RetroRemake/OtterX/README.md

# OtterX

An Open Source 6502-based, Commander X16-compatible, 8-bit Computer

## Where to buy?

Looking to order and build your own OtterX? Official kits are available from:

[Wavicle's store on Lectronz](https://lectronz.com/products/otterx-8-bit-retro-computer)
