RetroRemake/OtterX/Vega_EV1/OtterX_Vega_Packing_List.xlsx

OtterX Parts List
Bag 1:
 | D1, D3, D6, D7, D8, D9, D10, D11, D13, D14, D15, D19 | 12 | 1N4148 | Small Signal Diode
 | D2 | 1 | 1N5819 | Schottky diode
 | D4 | 1 | LED_GRN | Power ON
 | D5 | 1 | LED_YEL | Power SBY
 | D16, D20, D21, D22, D23, D24, D25, D26, D27, D28 | 10 | P4KE6.8CA | TVS Diode
 | D18 | 1 | LED_RED | Activity
 | R1, R2, R4, R5, R6, R13, R30, R31, R32, R33, R34 | 11 | 1K | Resistor
 | R3,R10,R12 | 3 | 2K2 | Resistor
 | R7,R8,R28 | 3 | 560R | Resistor
 | R9,R11,R16,R17,R19,R20 | 6 | 10K | Resistor
 | R15,R18,R21,R22 | 4 | 15K | Resistor
 | R23,R24,R27 | 3 | 100R | Resistor
 | R29 | 1 | 390R | Resistor
 | RN1 | 1 | 2K2 | 7 pin network resistor
 | RN2,RN3 | 2 | 2K2 | 5 pin network resistor
 | RN4 | 1 | 3K3 | 5 pin network resistor
 | RN5 | 1 | 2K2 | 8 pin network resistor
 | L1 | 1 | 470uH | Inductor
 | FB1 | 1 | FerriteBead_Small | Ferrite Bead
Bag 2:
 | C1, C2, C3, C4, C5, C6, C7, C8, C9, C10, C11, C12, C21, C22, C23, C24, C25, C26, C27, C28, C41, C44, C50, C54, C58, C59 | 26 | 0.1u | Capacitor
 | C13,C14,C15,C18,C19,C20 | 6 | 330p | Capacitor
 | C16,C17 | 2 | 3p | Capacitor
 | C42,C43 | 2 | 1n | Film Capacitor
 | C46,C47 | 2 | 2.2u | Film Capacitor
 | C51,C52,C53,C57 | 4 | 10u | Electrolytic Capacitor
 | C55,C56 | 2 | 3.3n | Film Capacitor
 | Q1,Q2,Q3 | 3 | 2N7000 | N-channel FET
 | Y1 | 1 | ECS-.327-6-13X | Real-time clock crystal
Bag 3:
 | H1,H2,H3,H4 | 4 | M3 18mm Brass Standoffs | M3 18mm Brass Standoffs
 | H1,H2,H3,H4 | 8 | M3x5mm screws | M3 screws
 | H1,H2,H3,H4 | 4 | M3 1mm nylon washers | M3 1mm Nylon Washers
 | BT1 | 1 | BAT-HLD-001-THM | CR2032 Battery Clip
 | F1 | 1 | JK30 | 3A Resettable Fuse
 | F3 | 1 | RXEF110 | 1.1A Resettable Fuse
 | F4 | 1 | RXEF025 | 250mA Resettable Fuse
 | F5 | 1 | RXEF010 | 100mA Resettable Fuse
Bag 4:
 | J1 | 1 | VERA_CONN | 2x13 2.54mm male header
 | J2 | 1 | VIA2 Header | 2x12 2.54mm male header
 | J3,J17,J21 | 3 | IDC_2x03 | 2x3 2.54mm shrouded box header
 | J5 | 1 | YM CT Out | 1x3 2.54mm male pin header
 | J6 | 1 | Ext. NMI | 1x2 2.54mm male header
 | J7 | 1 | RTC GPIO | 1x2 2.54mm male header
 | J9 | 1 | I2C | JST PH 4-pin connector
 | J10 | 1 | 1.5MB RAM Expansion | 2x20 2mm female header
 | J11 | 1 | KMDGX-6SG | Stacked PS/2 connector
 | J12 | 1 | VIA1 Extra Pins | 2x4 2.54mm male header
 | J14 | 1 | Flash WR EN | 1x2 2.54mm male header
 | J14+ | 1 | 2.54mm Jumper Cap | 2.54mm Jumper Cap
 | J16 | 1 | ATX-24 | ATX Power Socket
 | J25 | 1 | PS2 Pwr Src | 1x3 2.54mm Male pin header
 | J26 | 1 | Front Panel | 2x5 2.54mm Male pin header
 | J27 | 1 | EXTRAM_ENABLE | 1x3 2mm male pin header
 | J27+ | 1 | 2mm Jumper Cap | 2mm Jumper Cap
 | J29 | 1 | SD1-3525 | 3.5mm line level audio jack
 | P1 | 1 | Expansion slot | 2x30 card edge connector
 | SW1,SW2,SW3 | 3 | FSM4JH | Tactile switch / button
IC Box
 | U1 | 1 | W65C02S/W65C816S | CPU
 | U1-Opt | 1 |  | 40 pin DIP socket
 | U2 | 1 | W65C22S | VIA1
 | U2-Opt | 1 |  | 40 pin DIP socket
 | U3 | 1 | 74LS06 | Open Collector Inverter
 | U4 | 1 | 74AC10 | Triple 3-input NAND
 | U5,U6 | 2 | 74AHCT273 | Octal D Flip Flop
 | U7 | 1 | SST39SF040 | ROM
 | U7-Opt | 1 |  | 32 pin DIP socket, or ZIF socket
 | U8 | 1 | AS6C1008-55PCN | Low RAM
 | U9 | 1 | AS6C4008-55PCN | High RAM
 | U11 | 1 | 74ACT163 | Clock stretch counter
 | U12 | 1 | ATtiny861-20P | System Microcontroller
 | U13 | 1 | MCP7940N-xP | Real-time clock
 | U14 | 1 | 74ACT00 | Quad NAND gate
 | U15,U17 | 2 | 74AHCT02 | Quad NOR gate
 | U16 | 1 | 74AHCT04 | Hex Inverter
 | U18 | 1 | 74AHCT32 | Quad OR gate
 | U19,U20 | 2 | 74AC20 | Dual 4-input NAND
 | U21 | 1 | 74AHCT138 | 3-to-8 Decoder
 | U22 | 1 | TL074 | Audio mixer quad Op Amp
 | U24-Opt | 1 |  | 24 pin wide DIP socket
 | U25-Opt | 1 |  | 16 pin DIP socket
 | U26 | 1 | LM324 | Quad Op Amp
 | X1 | 1 | ACH-16.000MHZ-EK | System clock oscillator
 | X1-Opt |  |  | 4 pin oscillator socket
 | X2 | 1 | ECS-2100AX-3.579545MHZ | FM Audio oscillator
 | K1 | 1 | HK19F | Audio mute relay
VERA
 | VERA | 1 | VERA | VERA
OPM:
 | U24 | 1 | OPM2151 | FM Audio
 | U25 | 1 | OPM DAC | DAC for FM Audio
Loose
 | J18 | 1 | SNES0 | SNES Connector Left
 | J19 | 1 | SNES1 | SNES Connector Right
