RetroRemake/OtterX/(threads)

Thread 1 (2025-04-19):

[Sirius] U22 must be TL074

jburks, 2025-04-19:
Silkscreen for U22 says "LM324/TL074". This part must be TL074 because LM324 doesn't have sufficient power rail noise immunity.

Thread 2 (2025-04-19):

[Sirius] D23, D25, D26 are backwars

jburks, 2025-04-19:
The footprint for D23, D25, and D26 are backwards and will prevent keyboard and mouse from working even polarized TVS diodes are used.

Thread 4 (2025-04-19):

[Sirius] NES Pull-ups are too strong

jburks, 2025-04-19:
The NES used 10K pull-ups. Current pull-ups are 2.2K through RN6. Super cheap replacement NES controllers sample the select button and transmit data on the same pin causing them to rely on the pull-up being weak.

Thread 5 (2025-04-19):

[Sirius] ROM Chip Select is not muted when ROM bank is >= 32

jburks, 2025-04-19:
ROM is responding when a cartridge is being addressed. This requires a bodge and bodge board to correct.

jburks, 2025-04-19:
It is possible to connect /ROMEN, ROMBA19, ROMBA20, and ROMBA21 to the two unused gates on U18 and then use two diodes to wire-OR their outputs into a new /LOWROMEN signal. The routing congestion around U18 is pretty high; this would probably require re-routing a dozen other signals.

Thread 6 (2025-04-19):

[Sirius] VIA2 connector missing reset

jburks, 2025-04-19:
Pin 21 of VIA2 header should be /RES but is unconnected.

Thread 7 (2025-04-19):

[Sirius] Memory expansion doesn't clear cartridge keepout

jburks, 2025-04-19:
The memory expansion header, J10 is too close to the card edge connector for a cartridge in a Famicom shell to be inserted when the memory expansion is present.

Best solution here may be a 90-degree riser card due to the manufacturing complexity of a port extender.

Thread 8 (2025-04-19):

[Sirius] OPM2151 doesn't clear cartridge keepout

jburks, 2025-04-19:
The YM2151 footprint is close to P1 and causes cartridge shells to rub up against OPM2151 when it is installed instead of YM2151.

Thread 10 (2025-04-20):

[Sirius] Digital signals routed across analog mixer

jburks, 2025-04-20:
/VERA_CS and /VIA_CS are routed across the analog mixer. Probably not a big deal, but this could result in coupling from these digital signals onto the analog signal. The coupling would most likely occur every VBLANK interrupt which is just below 60Hz.

Thread 11 (2025-04-20):

[Sirius] NESDAT0 should go through filtering cap

jburks, 2025-04-20:
The filtering cap C15 connected to NESDAT0 should sit between pin 4 of the SNES port and the VIA pin. Currently it is only connected through the TVS diode.

Thread 13 (2025-04-20):

[Sirius] RTC load caps may be wrong value

jburks, 2025-04-20:
The load caps C16 and C17 are currently 3pF each into a 6pf crystal. The total capacitance seen by the crystal may be less than 6pf.

Thread 14 (2025-04-20):

[Sirius] DIP footprints may need 1mm holes

jburks, 2025-04-20:
The DIP footprints with short wide pads have 0.8mm holes. This makes desoldering significantly more challenging. These maybe need to be 1.0mm.

Thread 15 (2025-04-20):

[Sirius] DIN-6 Footprint doesn't match part

jburks, 2025-04-20:
The DIN-6 Footprint used doesn't match that of the AliEx part sourced. Pins 7 and 8 have different spacing.

Thread 16 (2025-06-14):

Q1, Q2, and Q3 need wider footprints

jburks, 2025-06-14:
The 1.27mm spacing on TO-92 transistors is creating a lot of assembly errors. Replace with kinked-pin / wide TO-92 footprint to ease assembly.
