RetroRemake/OtterX/VIA2Expansion/VIA2Expansion.kicad_pcb

## KiCad design VIA2Expansion/VIA2Expansion.kicad_pcb (2026-06-11)

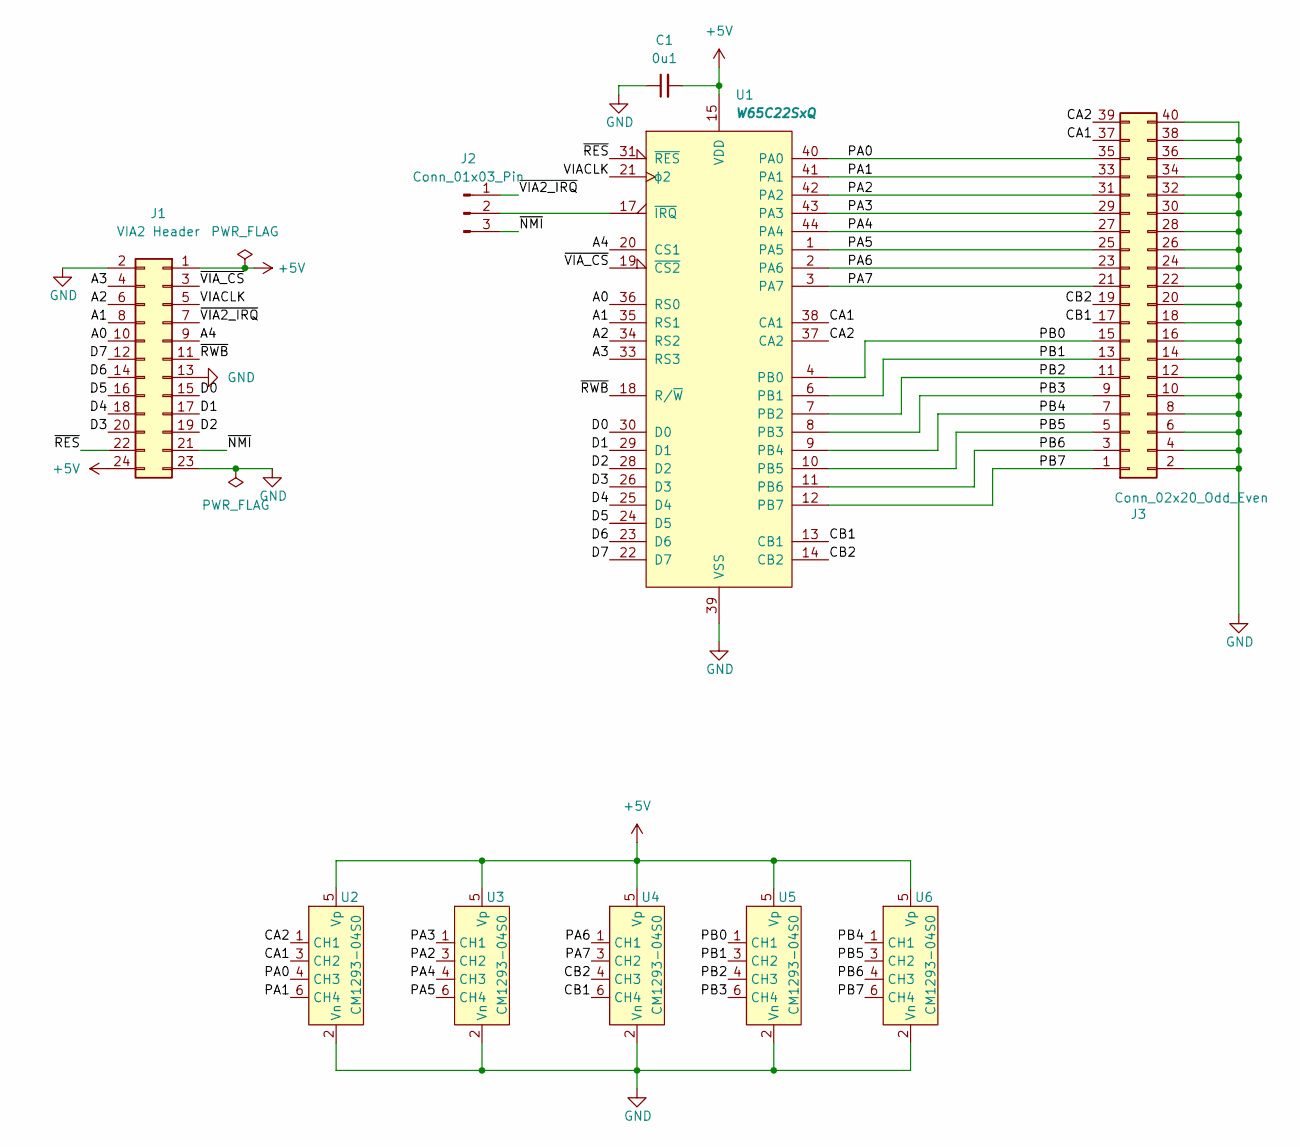
[picture p1: schematic VIA2Expansion.kicad_sch]

Parts:
C1: 0u1; C_0603_1608Metric
J1: VIA2 Header; PinSocket_2x12_P2.54mm_Horizontal
J2: Conn_01x03_Pin; PinHeader_1x03_P2.54mm_Vertical
J3: Conn_02x20_Odd_Even; IDC-Header_2x20_P2.54mm_Vertical
U1: W65C22SxQ; TQFP-44_10x10mm_P0.8mm
U2, U3, U4, U5, U6: CM1293-04S0; SC-74-6_1.55x2.9mm_P0.95mm

Connections:
+5V: C1.2, J1.1, J1.24, U1.15 (VDD), U2.5 (Vp), U3.5 (Vp), U4.5 (Vp), U5.5 (Vp), U6.5 (Vp)
/A0: J1.10, U1.36 (RS0)
/A1: J1.8, U1.35 (RS1)
/A2: J1.6, U1.34 (RS2)
/A3: J1.4, U1.33 (RS3)
/A4: J1.9, U1.20 (CS1)
/CA1: J3.37, U1.38 (CA1), U2.3 (CH2)
/CA2: J3.39, U1.37 (CA2), U2.1 (CH1)
/CB1: J3.17, U1.13 (CB1), U4.6 (CH4)
/CB2: J3.19, U1.14 (CB2), U4.4 (CH3)
/D0: J1.15, U1.30 (D0)
/D1: J1.17, U1.29 (D1)
/D2: J1.19, U1.28 (D2)
/D3: J1.20, U1.26 (D3)
/D4: J1.18, U1.25 (D4)
/D5: J1.16, U1.24 (D5)
/D6: J1.14, U1.23 (D6)
/D7: J1.12, U1.22 (D7)
/PA0: J3.35, U1.40 (PA0), U2.4 (CH3)
/PA1: J3.33, U1.41 (PA1), U2.6 (CH4)
/PA2: J3.31, U1.42 (PA2), U3.3 (CH2)
/PA3: J3.29, U1.43 (PA3), U3.1 (CH1)
/PA4: J3.27, U1.44 (PA4), U3.4 (CH3)
/PA5: J3.25, U1.1 (PA5), U3.6 (CH4)
/PA6: J3.23, U1.2 (PA6), U4.1 (CH1)
/PA7: J3.21, U1.3 (PA7), U4.3 (CH2)
/PB0: J3.15, U1.4 (PB0), U5.1 (CH1)
/PB1: J3.13, U1.6 (PB1), U5.3 (CH2)
/PB2: J3.11, U1.7 (PB2), U5.4 (CH3)
/PB3: J3.9, U1.8 (PB3), U5.6 (CH4)
/PB4: J3.7, U1.9 (PB4), U6.1 (CH1)
/PB5: J3.5, U1.10 (PB5), U6.3 (CH2)
/PB6: J3.3, U1.11 (PB6), U6.4 (CH3)
/PB7: J3.1, U1.12 (PB7), U6.6 (CH4)
/VIACLK: J1.5, U1.21 (ϕ2)
/~NMI: J1.21, J2.3
/~RES: J1.22, U1.31 (~RES)
/~RWB: J1.11, U1.18 (R/~W)
/~VIA2_IRQ: J1.7, J2.1
/~VIA_CS: J1.3, U1.19 (~CS2)
GND: C1.1, J1.2, J1.13, J1.23, J3.2, J3.4, J3.6, J3.8, J3.10, J3.12, J3.14, J3.16, J3.18, J3.20, J3.22, J3.24, J3.26, J3.28, J3.30, J3.32, J3.34, J3.36, J3.38, J3.40, U1.39 (VSS), U2.2 (Vn), U3.2 (Vn), U4.2 (Vn), U5.2 (Vn), U6.2 (Vn)
unnamed: J2.2, U1.17 (~IRQ)

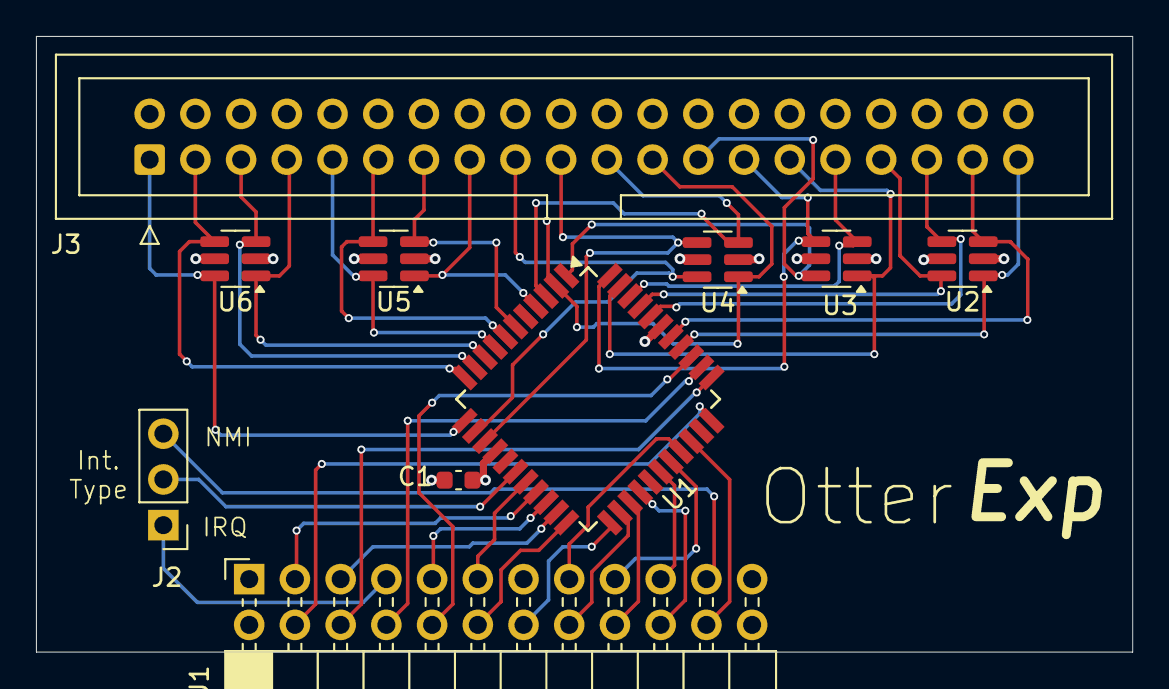
[picture p2: board VIA2Expansion.kicad_pcb from above]

Board: 4 copper layers, 60.9 x 34.2 mm, 10 parts (0 on the bottom side), 42 nets.
