RetroRemake/OtterX/Sirius_DV1/OtterX.kicad_pcb

## KiCad design Sirius_DV1/OtterX.kicad_pcb (2026-06-11)

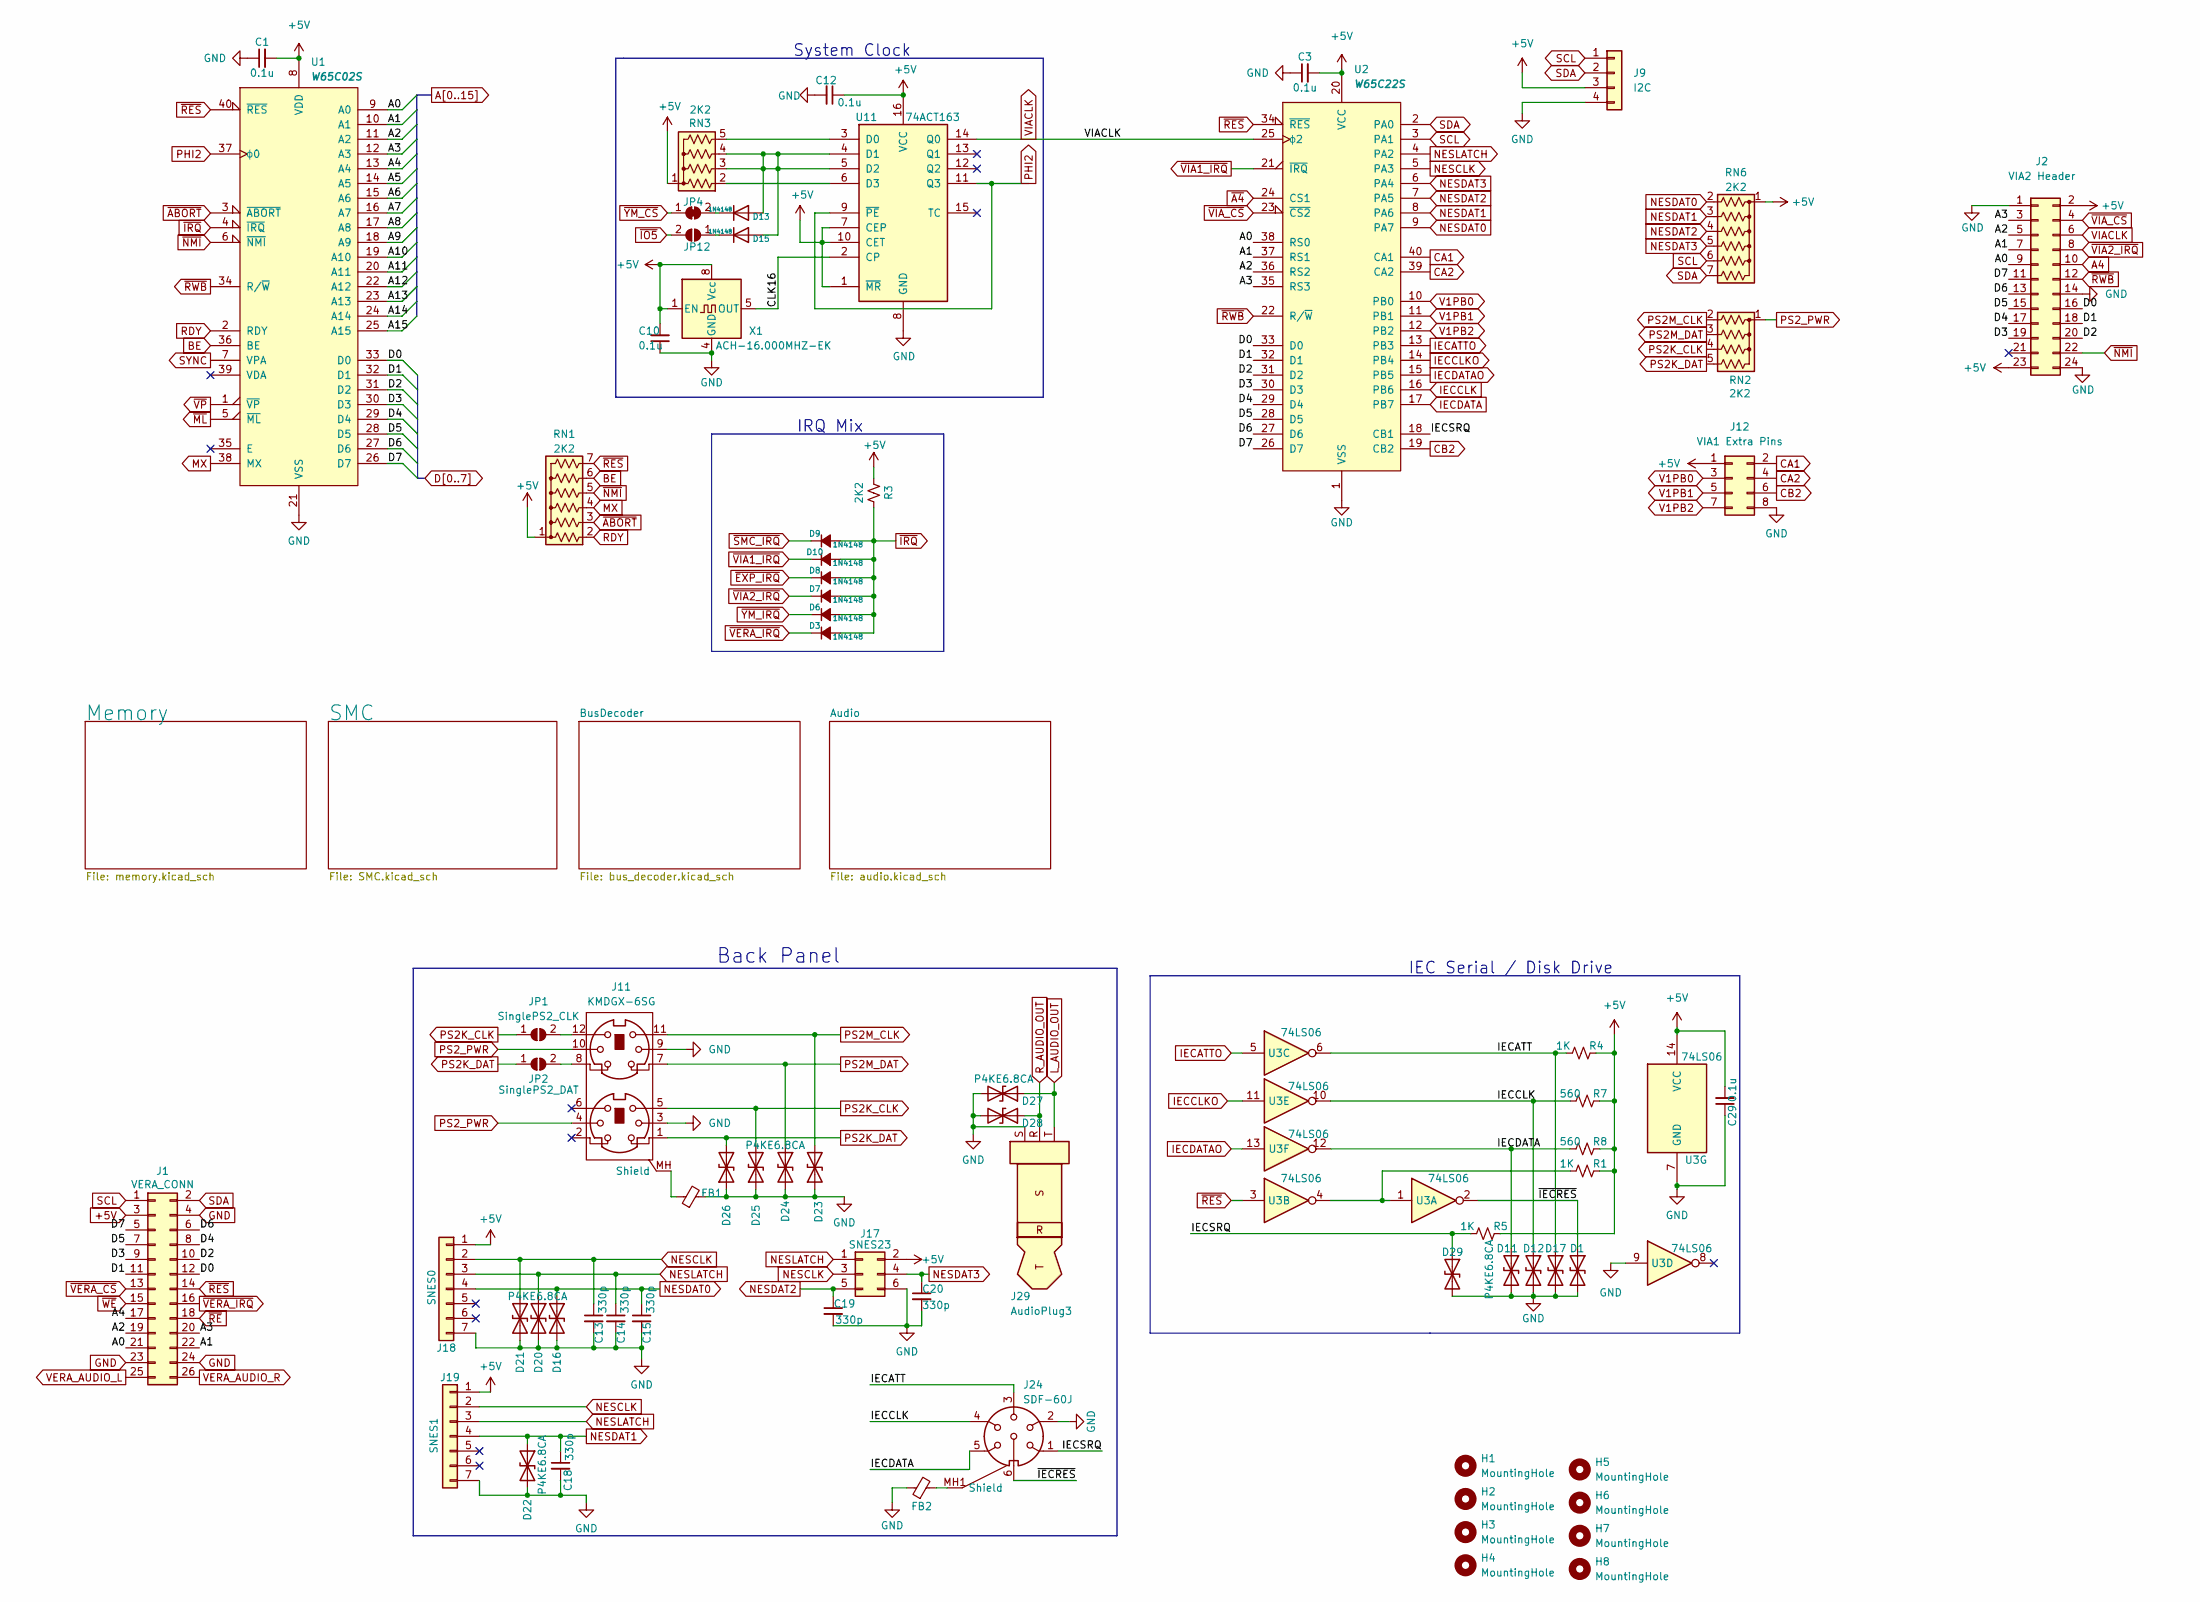
[picture p3: schematic OtterX.kicad_sch]

Parts:
C1, C3, C10, C12, C29: 0.1u; C_Disc_D4.3mm_W1.9mm_P5.00mm
C13, C14, C15, C18, C19, C20: 330p; C_Disc_D4.3mm_W1.9mm_P5.00mm
D1, D11, D12, D16, D17, D20, D21, D22, D23, D24, D25, D26, D27, D28, D29: P4KE6.8CA; D_DO-41_SOD81_P7.62mm_Horizontal
D3, D6, D7, D8, D9, D10: 1N4148; D_DO-34_SOD68_P7.62mm_Horizontal
D13, D15: 1N4148; D_DO-35_SOD27_P7.62mm_Horizontal
FB1, FB2: FerriteBead_Small; L_Axial_L5.0mm_D3.6mm_P10.00mm_Horizontal_Murata_BL01RN1A2A2
H1, H2, H3, H4: MountingHole; MountingHole_3.2mm_M3
H5, H6, H7, H8: MountingHole; MountingHole_4.3mm_M4
J1: VERA_CONN; PinHeader_2x13_P2.54mm_Vertical
J2: VIA2 Header; PinSocket_2x12_P2.54mm_Vertical
J9: I2C; JST_PH_B4B-PH-K_1x04_P2.00mm_Vertical
J11: KMDGX-6SG; Kycon KMDGX-6SG P-S4N
J12: VIA1 Extra Pins; PinHeader_2x04_P2.54mm_Vertical
J17: SNES23; PinSocket_2x03_P2.54mm_Vertical
J18: SNES0; SNES_L
J19: SNES1; SNES_R
J24: SDF-60J; SDF60J
J29: AudioPlug3; Jack_3.5mm_CUI_SJ1-3525N_Horizontal
JP1: SinglePS2_CLK; SolderJumper-2_P1.3mm_Bridged_Pad1.0x1.5mm
JP2: SinglePS2_DAT; SolderJumper-2_P1.3mm_Bridged_Pad1.0x1.5mm
JP4: SolderJumper_2_Bridged; SolderJumper-2_P1.3mm_Bridged_Pad1.0x1.5mm
JP12: IO3 Clk Stretch; SolderJumper-2_P1.3mm_Open_Pad1.0x1.5mm
R1, R4, R5: 1K; R_Axial_DIN0207_L6.3mm_D2.5mm_P7.62mm_Horizontal
R3: 2K2; R_Axial_DIN0207_L6.3mm_D2.5mm_P10.16mm_Horizontal
R7, R8: 560; R_Axial_DIN0207_L6.3mm_D2.5mm_P7.62mm_Horizontal
RN1, RN6: 2K2; R_Array_SIP7
RN2, RN3: 2K2; R_Array_SIP5
U1: W65C02S; DIP-40_W15.24mm-ShortWidePads
U2: W65C22S; DIP-40_W15.24mm-ShortWidePads
U3: 74LS06; DIP-14_W7.62mm_ShortWidePads
U11: 74ACT163; DIP-16_W7.62mm_ShortWidePads
X1: ACH-16.000MHZ-EK; Oscillator_DIP-8

Connections:
+5V: C1.2, C3.2, C10.2, C12.1, C29.2, J1.3, J2.2, J2.23, J9.3, J12.1, J17.2, J18.1, J19.1, R1.1, R3.1, R4.1, R5.1, R7.1, R8.1, RN1.1 (common), RN3.1 (common), RN6.1 (common), U1.8 (VDD), U2.20 (VCC), U3.14 (VCC), U11.1 (~MR), U11.7 (CEP), U11.10 (CET), U11.16 (VCC), X1.1 (EN), X1.8 (Vcc); also elsewhere on the board
/CLK16: U11.2 (CP), X1.5 (OUT)
/IECATT: D17.1 (A1), J24.3, R4.2, U3.6
/IECSRQ: D29.1 (A1), J24.1, R5.2, U2.18 (CB1)
/~IECRES: D1.1 (A1), J24.6, U3.2
A0: J1.21, J2.9, U1.9 (A0), U2.38 (RS0); also elsewhere on the board
A1: J1.22, J2.7, U1.10 (A1), U2.37 (RS1); also elsewhere on the board
A2: J1.19, J2.5, U1.11 (A2), U2.36 (RS2); also elsewhere on the board
A3: J1.20, J2.3, U1.12 (A3), U2.35 (RS3); also elsewhere on the board
A4: J1.17, J2.10, U1.13 (A4); also elsewhere on the board
A5: U1.14 (A5); also elsewhere on the board
A6: U1.15 (A6); also elsewhere on the board
A7: U1.16 (A7); also elsewhere on the board
A8: U1.17 (A8); also elsewhere on the board
A9: U1.18 (A9); also elsewhere on the board
A10: U1.19 (A10); also elsewhere on the board
A11: U1.20 (A11); also elsewhere on the board
A12: U1.22 (A12); also elsewhere on the board
A13: U1.23 (A13); also elsewhere on the board
A14: U1.24 (A14); also elsewhere on the board
A15: U1.25 (A15); also elsewhere on the board
BE: RN1.6 (R5), U1.36 (BE); also elsewhere on the board
CA1: J12.2, U2.40 (CA1)
CA2: J12.4, U2.39 (CA2)
CB2: J12.6, U2.19 (CB2)
D0: J1.12, J2.16, U1.33 (D0), U2.33 (D0); also elsewhere on the board
D1: J1.11, J2.18, U1.32 (D1), U2.32 (D1); also elsewhere on the board
D2: J1.10, J2.20, U1.31 (D2), U2.31 (D2); also elsewhere on the board
D3: J1.9, J2.19, U1.30 (D3), U2.30 (D3); also elsewhere on the board
D4: J1.8, J2.17, U1.29 (D4), U2.29 (D4); also elsewhere on the board
D5: J1.7, J2.15, U1.28 (D5), U2.28 (D5); also elsewhere on the board
D6: J1.6, J2.13, U1.27 (D6), U2.27 (D6); also elsewhere on the board
D7: J1.5, J2.11, U1.26 (D7), U2.26 (D7); also elsewhere on the board
GND: C1.1, C3.1, C10.1, C12.2, C13.2, C14.2, C15.2, C18.2, C19.2, C20.2, C29.1, D1.2 (A2), D11.2 (A2), D12.2 (A2), D16.2 (A2), D17.2 (A2), D20.2 (A2), D21.2 (A2), D22.2 (A2), D23.1 (A1), D24.2 (A2), D25.1 (A1), D26.1 (A1), D27.2 (A2), D28.2 (A2), D29.2 (A2), FB1.2, FB2.1, J1.4, J1.23, J1.24, J2.1, J2.14, J2.24, J9.4, J11.3, J11.9, J12.8, J17.6, J18.7, J19.7, J24.2, J29.S, U1.21 (VSS), U2.1 (VSS), U3.7 (GND), U3.9, U11.8 (GND), X1.4 (GND); also elsewhere on the board
IECATTO: U2.13 (PB3), U3.5
IECCLK: D12.1 (A1), J24.4, R7.2, U2.16 (PB6), U3.10
IECCLKO: U2.14 (PB4), U3.11
IECDATA: D11.1 (A1), J24.5, R8.2, U2.17 (PB7), U3.12
IECDATAO: U2.15 (PB5), U3.13
L_AUDIO_OUT: D27.1 (A1), J29.T; also elsewhere on the board
MX: RN1.4 (R3), U1.38 (MX)
NESCLK: C13.1, D21.1 (A1), J17.3, J18.2, J19.2, U2.5 (PA3)
NESDAT0: C15.1, D16.1 (A1), J18.4, RN6.2 (R1), U2.9 (PA7)
NESDAT1: C18.1, D22.1 (A1), J19.4, RN6.3 (R2), U2.8 (PA6)
NESDAT2: C19.1, J17.5, RN6.4 (R3), U2.7 (PA5)
NESDAT3: C20.1, J17.4, RN6.5 (R4), U2.6 (PA4)
NESLATCH: C14.1, D20.1 (A1), J17.1, J18.3, J19.3, U2.4 (PA2)
unnamed: D13.2 (A), D15.2 (A), RN3.3 (R2), RN3.4 (R3), U11.4 (D1), U11.5 (D2)
unnamed: D13.1 (K), JP4.2 (B)
unnamed: D15.1 (K), JP12.1 (A)
unnamed: FB1.1, J11.MH (Shield)
unnamed: FB2.2, J24.MH1 (Shield), J24.MH2
unnamed: J11.12, JP1.2 (B)
unnamed: J11.8, JP2.2 (B)
unnamed: R1.2, U3.1, U3.4
unnamed: RN3.2 (R1), U11.6 (D3)
unnamed: RN3.5 (R4), U11.3 (D0)
PHI2: U1.37 (ϕ0), U11.9 (~PE), U11.11 (Q3); also elsewhere on the board
PS2K_CLK: D25.2 (A2), J11.5, JP1.1 (A), RN2.4 (R3); also elsewhere on the board
PS2K_DAT: D26.2 (A2), J11.1, JP2.1 (A), RN2.5 (R4); also elsewhere on the board
PS2M_CLK: D23.2 (A2), J11.11, RN2.2 (R1); also elsewhere on the board
PS2M_DAT: D24.1 (A1), J11.7, RN2.3 (R2); also elsewhere on the board
PS2_PWR: J11.4, J11.10, RN2.1 (common); also elsewhere on the board
RDY: RN1.2 (R1), U1.2 (RDY); also elsewhere on the board
R_AUDIO_OUT: D28.1 (A1), J29.R; also elsewhere on the board
SCL: J1.1, J9.1, RN6.6 (R5), U2.3 (PA1); also elsewhere on the board
SDA: J1.2, J9.2, RN6.7 (R6), U2.2 (PA0); also elsewhere on the board
SYNC: U1.7 (VPA); also elsewhere on the board
V1PB0: J12.3, U2.10 (PB0)
V1PB1: J12.5, U2.11 (PB1)
V1PB2: J12.7, U2.12 (PB2)
VERA_AUDIO_L: J1.25; also elsewhere on the board
VERA_AUDIO_R: J1.26; also elsewhere on the board
VIACLK: J2.6, U2.25 (ϕ2), U11.14 (Q0)
~A4: U2.24 (CS1); also elsewhere on the board
~ABORT: RN1.3 (R2), U1.3 (~ABORT)
~EXP_IRQ: D8.1 (K); also elsewhere on the board
~IO5: JP12.2 (B); also elsewhere on the board
~IRQ: D3.2 (A), D6.2 (A), D7.2 (A), D8.2 (A), D9.2 (A), D10.2 (A), R3.2, U1.4 (~IRQ)
~ML: U1.5 (~ML); also elsewhere on the board
~NMI: J2.22, RN1.5 (R4), U1.6 (~NMI); also elsewhere on the board
~RES: J1.14, RN1.7 (R6), U1.40 (~RES), U2.34 (~RES), U3.3; also elsewhere on the board
~RE: J1.18; also elsewhere on the board
~RWB: J2.12, U1.34 (R/~W), U2.22 (R/~W); also elsewhere on the board
~SMC_IRQ: D9.1 (K); also elsewhere on the board
~VERA_CS: J1.13; also elsewhere on the board
~VERA_IRQ: D3.1 (K), J1.16
~VIA1_IRQ: D10.1 (K), U2.21 (~IRQ)
~VIA2_IRQ: D7.1 (K), J2.8
~VIA_CS: J2.4, U2.23 (~CS2); also elsewhere on the board
~VP: U1.1 (~VP); also elsewhere on the board
~WE: J1.15; also elsewhere on the board
~YM_CS: JP4.1 (A); also elsewhere on the board
~YM_IRQ: D6.1 (K); also elsewhere on the board

Notes on the sheet:
System Clock
Back Panel
IRQ Mix
IEC Serial / Disk Drive

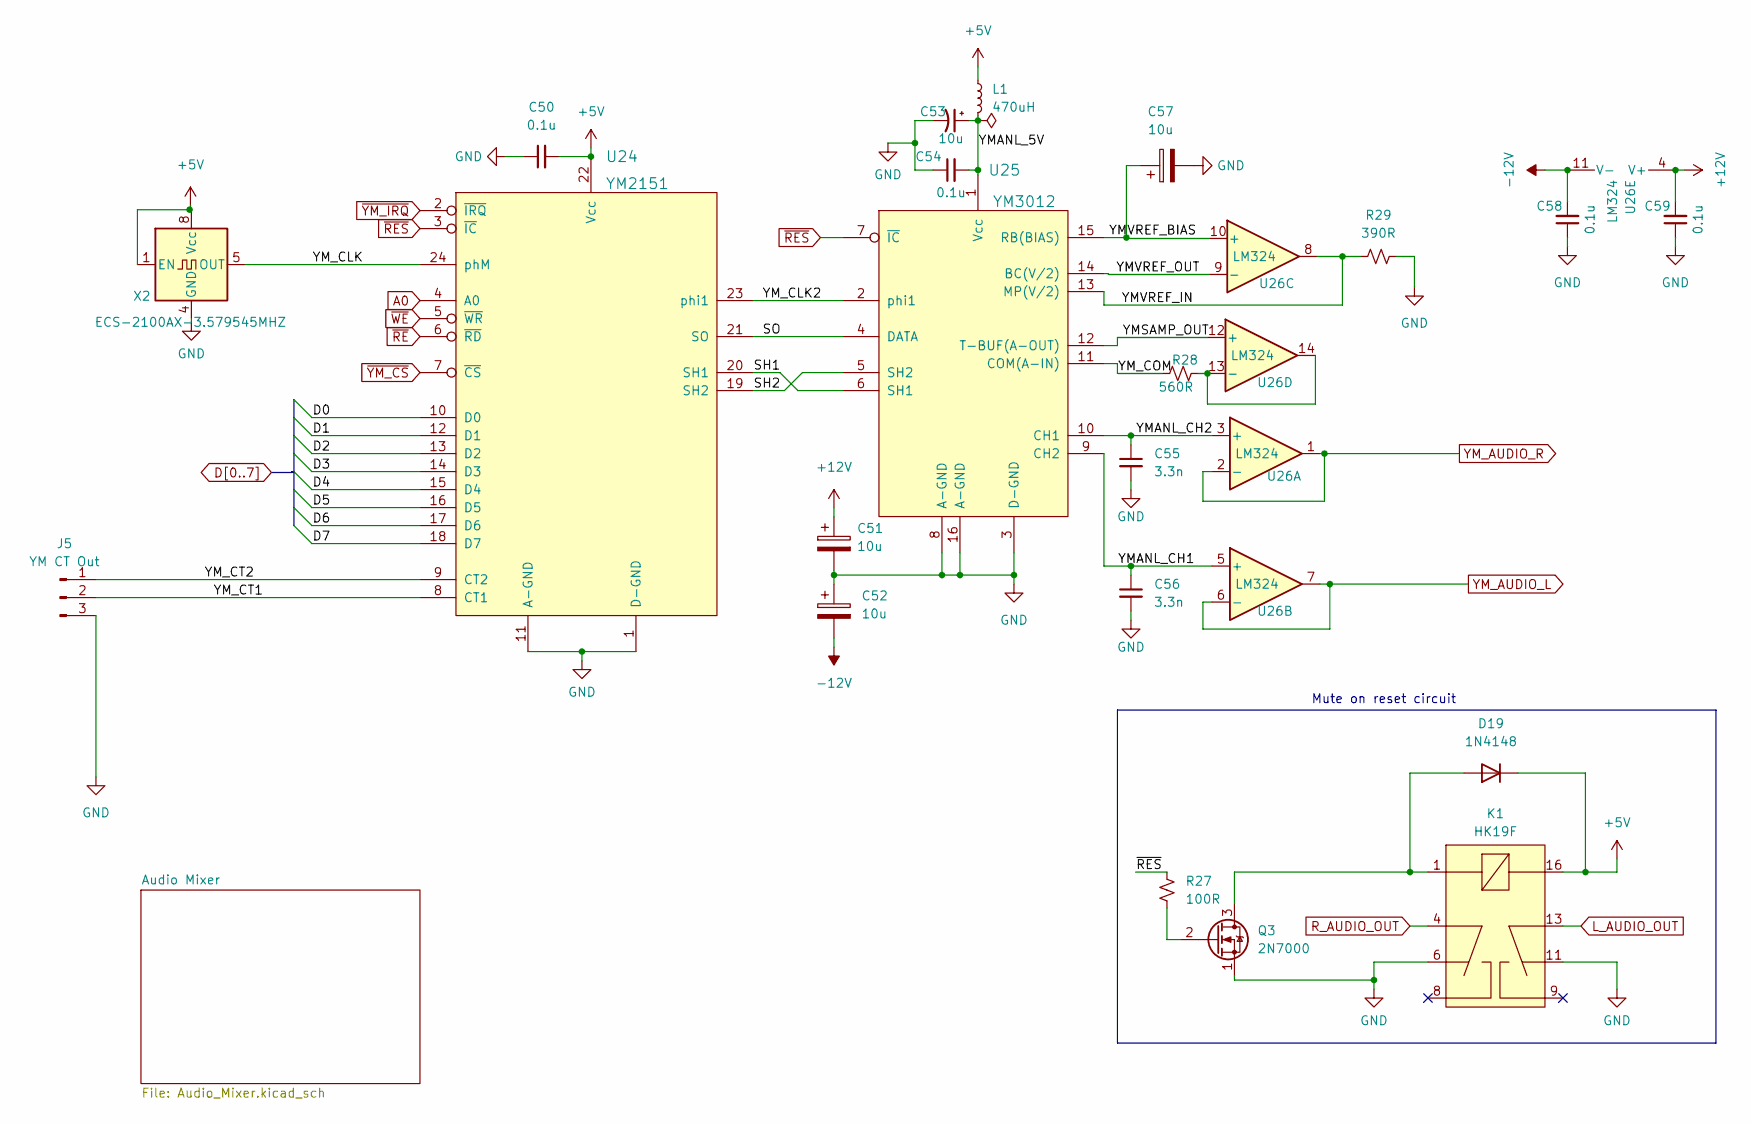
[picture p4: schematic audio.kicad_sch, OtterX]

Parts:
C50, C54, C58, C59: 0.1u; C_Disc_D4.3mm_W1.9mm_P5.00mm
C51, C52, C53, C57: 10u; CP_Radial_D5.0mm_P2.50mm
C55, C56: 3.3n; C_Rect_L7.2mm_W2.5mm_P5.00mm_FKS2_FKP2_MKS2_MKP2
D19: 1N4148; D_DO-35_SOD27_P7.62mm_Horizontal
J5: YM CT Out; PinHeader_1x03_P2.54mm_Vertical
K1: HK19F; HK19F-DPDT-Relay
L1: 470uH; L_Axial_L5.0mm_D3.6mm_P10.00mm_Horizontal_Murata_BL01RN1A2A2
Q3: 2N7000; TO-92_Inline
R27: 100R; R_Axial_DIN0207_L6.3mm_D2.5mm_P7.62mm_Horizontal
R28: 560R; R_Axial_DIN0207_L6.3mm_D2.5mm_P7.62mm_Horizontal
R29: 390R; R_Axial_DIN0207_L6.3mm_D2.5mm_P7.62mm_Horizontal
U24: YM2151; DIP-24_W15.24mm_ShortWidePads
U25: YM3012; DIP-16_W7.62mm_ShortWidePads
U26: LM324; DIP-14_W7.62mm_ShortWidePads
X2: ECS-2100AX-3.579545MHZ; Oscillator_DIP-8

Connections:
+5V: C50.2, D19.1 (K), K1.16, L1.1, U24.22 (Vcc), X2.1 (EN), X2.8 (Vcc); also elsewhere on the board
+12V: C51.1, C59.2, U26.4 (V+); also elsewhere on the board
-12V: C52.2, C58.2, U26.11 (V-); also elsewhere on the board
/Audio/SH1: U24.20 (SH1), U25.6 (SH1)
/Audio/SH2: U24.19 (SH2), U25.5 (SH2)
/Audio/SO: U24.21 (SO), U25.4 (DATA)
/Audio/YMANL_5V: C53.1, C54.2, L1.2, U25.1 (Vcc)
/Audio/YMANL_CH1: C56.1, U25.9 (CH2), U26.5 (+)
/Audio/YMANL_CH2: C55.1, U25.10 (CH1), U26.3 (+)
/Audio/YMSAMP_OUT: U25.12 (T-BUF(A-OUT)), U26.12 (+)
/Audio/YMVREF_BIAS: C57.1, U25.15 (RB(BIAS)), U26.10 (+)
/Audio/YMVREF_IN: R29.1, U25.13 (MP(V/2)), U26.8
/Audio/YMVREF_OUT: U25.14 (BC(V/2)), U26.9 (-)
/Audio/YM_CLK: U24.24 (phM), X2.5 (OUT)
/Audio/YM_CLK2: U24.23 (phi1), U25.2 (phi1)
/Audio/YM_COM: R28.2, U25.11 (COM(A-IN))
/Audio/YM_CT1: J5.2, U24.8 (CT1)
/Audio/YM_CT2: J5.1, U24.9 (CT2)
A0: U24.4 (A0); also elsewhere on the board
D0: U24.10 (D0); also elsewhere on the board
D1: U24.12 (D1); also elsewhere on the board
D2: U24.13 (D2); also elsewhere on the board
D3: U24.14 (D3); also elsewhere on the board
D4: U24.15 (D4); also elsewhere on the board
D5: U24.16 (D5); also elsewhere on the board
D6: U24.17 (D6); also elsewhere on the board
D7: U24.18 (D7); also elsewhere on the board
GND: C50.1, C51.2, C52.1, C53.2, C54.1, C55.2, C56.2, C57.2, C58.1, C59.1, J5.3, K1.6, K1.11, Q3.1 (S), R29.2, U24.1 (D-GND), U24.11 (A-GND), U25.3 (D-GND), U25.8 (A-GND), U25.16 (A-GND), X2.4 (GND); also elsewhere on the board
L_AUDIO_OUT: K1.13; also elsewhere on the board
unnamed: D19.2 (A), K1.1, Q3.3 (D)
unnamed: Q3.2 (G), R27.2
unnamed: R28.1, U26.13 (-), U26.14
R_AUDIO_OUT: K1.4; also elsewhere on the board
YM_AUDIO_L: U26.6 (-), U26.7; also elsewhere on the board
YM_AUDIO_R: U26.1, U26.2 (-); also elsewhere on the board
~RES: R27.1, U24.3 (~IC), U25.7 (~IC); also elsewhere on the board
~RE: U24.6 (~RD); also elsewhere on the board
~WE: U24.5 (~WR); also elsewhere on the board
~YM_CS: U24.7 (~CS); also elsewhere on the board
~YM_IRQ: U24.2 (~IRQ); also elsewhere on the board

Notes on the sheet:
Mute on reset circuit

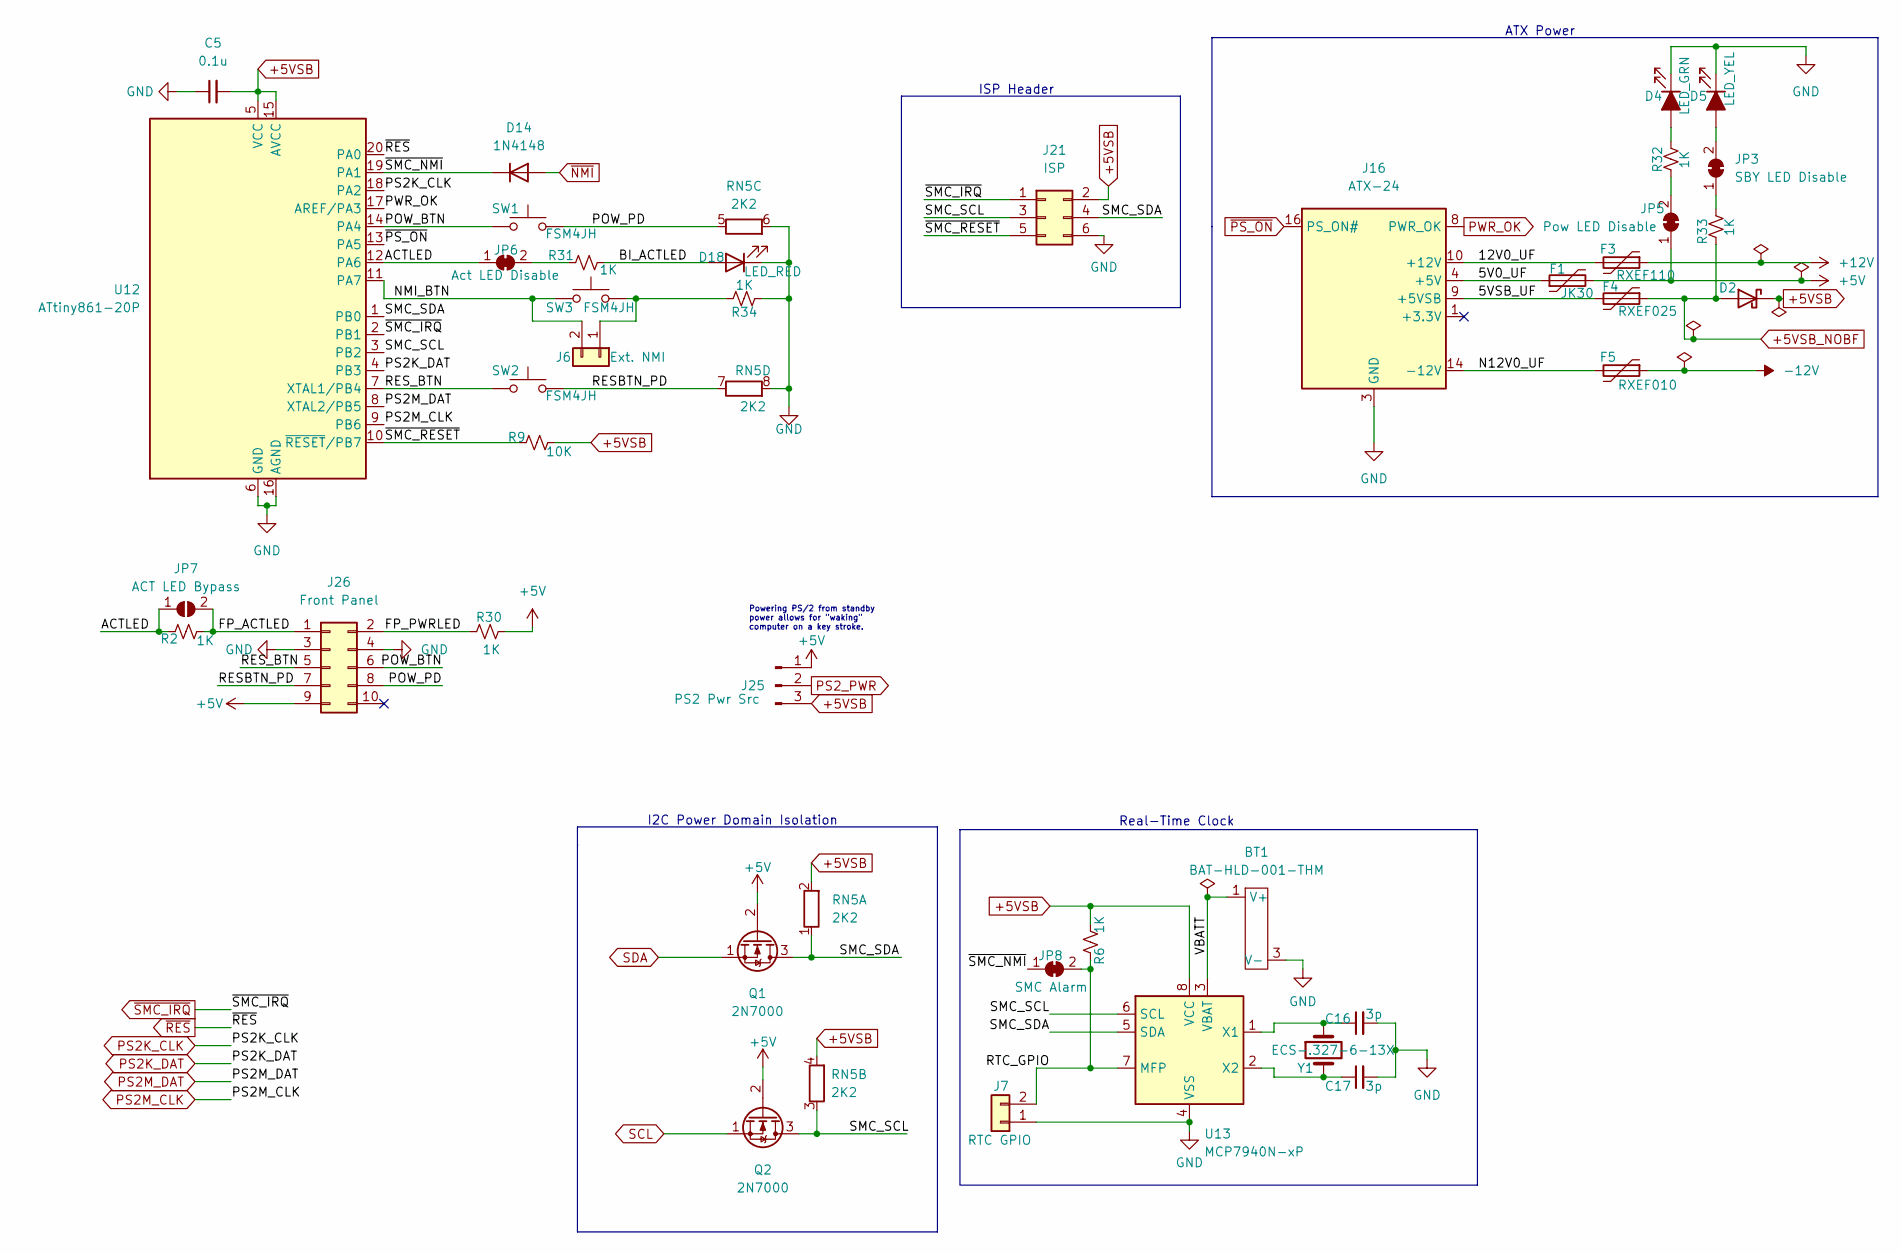
[picture p5: schematic SMC.kicad_sch, OtterX]

Parts:
BT1: BAT-HLD-001-THM; CELL_BATT_CLIP
C5: 0.1u; C_Disc_D4.3mm_W1.9mm_P5.00mm
C16, C17: 3p; C_Disc_D3.8mm_W2.6mm_P2.50mm
D2: 1N5819; D_DO-34_SOD68_P7.62mm_Horizontal
D4: LED_GRN; LED_D3.0mm
D5: LED_YEL; LED_D3.0mm
D14: 1N4148; D_DO-35_SOD27_P7.62mm_Horizontal
D18: LED_RED; LED_D3.0mm
F1: JK30; Fuse_Bourns_MF-RG400
F3: RXEF110; Fuse_Bourns_MF-RG400
F4: RXEF025; Fuse_Bourns_MF-RG300
F5: RXEF010; Fuse_Bourns_MF-RG400
J6: Ext. NMI; PinHeader_1x02_P2.54mm_Vertical
J7: RTC GPIO; PinHeader_1x02_P2.54mm_Vertical
J16: ATX-24; 1-1775099-3-Fixed
J21: ISP; IDC-Header_2x03_P2.54mm_Vertical
J25: PS2 Pwr Src; PinHeader_1x03_P2.54mm_Vertical
J26: Front Panel; PinHeader_2x05_P2.54mm_Vertical
JP3: SBY LED Disable; SolderJumper-2_P1.3mm_Bridged_Pad1.0x1.5mm
JP5: Pow LED Disable; SolderJumper-2_P1.3mm_Bridged_Pad1.0x1.5mm
JP6: Act LED Disable; SolderJumper-2_P1.3mm_Bridged_Pad1.0x1.5mm
JP7: ACT LED Bypass; SolderJumper-2_P1.3mm_Open_Pad1.0x1.5mm
JP8: SMC Alarm; SolderJumper-2_P1.3mm_Bridged_Pad1.0x1.5mm
Q1, Q2: 2N7000; TO-92_Inline
R2, R6, R30, R31, R32, R33, R34: 1K; R_Axial_DIN0207_L6.3mm_D2.5mm_P7.62mm_Horizontal
R9: 10K; R_Axial_DIN0207_L6.3mm_D2.5mm_P7.62mm_Horizontal
RN5: 2K2; R_Array_SIP8
SW1, SW2, SW3: FSM4JH; Tactile Switch Dual
U12: ATtiny861-20P; DIP-20_W7.62mm_ShortWidePads
U13: MCP7940N-xP; DIP-8_W7.62mm
Y1: ECS-.327-6-13X; Crystal_DS26_D2.0mm_L6.0mm_Horizontal

Connections:
+5V: F1.2, J25.1, J26.9, JP5.1 (A), Q1.2 (G), Q2.2 (G), R30.2; also elsewhere on the board
+5VSB: C5.2, D2.1 (K), J21.2, J25.3, R6.2, R9.2, RN5.2 (R1.2), RN5.4 (R2.2), U12.5 (VCC), U12.15 (AVCC), U13.8 (VCC)
+5VSB_NOBF: D2.2 (A), F4.1, R33.1
+12V: F3.1; also elsewhere on the board
-12V: F5.1; also elsewhere on the board
/SMC/5V0_UF: F1.1, J16.4 (+5V), J16.6 (+5V), J16.21 (+5V), J16.22 (+5V), J16.23 (+5V)
/SMC/5VSB_UF: F4.2, J16.9 (+5VSB)
/SMC/12V0_UF: F3.2, J16.10 (+12V), J16.11 (+12V)
/SMC/ACTLED: JP6.1 (A), JP7.1 (A), R2.1, U12.12 (PA6)
/SMC/BI_ACTLED: D18.2 (A), R31.2
/SMC/FP_ACTLED: J26.1, JP7.2 (B), R2.2
/SMC/FP_PWRLED: J26.2, R30.1
/SMC/N12V0_UF: F5.2, J16.14 (-12V)
/SMC/NMI_BTN: J6.2, SW3.1, U12.11 (PA7)
/SMC/POW_BTN: J26.6, SW1.1, U12.14 (PA4)
/SMC/POW_PD: J26.8, RN5.5 (R3.1), SW1.2
/SMC/RESBTN_PD: J26.7, RN5.7 (R4.1), SW2.2
/SMC/RES_BTN: J26.5, SW2.1, U12.7 (XTAL1/PB4)
/SMC/RTC_GPIO: J7.2, JP8.2 (B), R6.1, U13.7 (MFP)
/SMC/SMC_SCL: J21.3, Q2.3 (D), RN5.3 (R2.1), U12.3 (PB2), U13.6 (SCL)
/SMC/SMC_SDA: J21.4, Q1.3 (D), RN5.1 (R1.1), U12.1 (PB0), U13.5 (SDA)
/SMC/VBATT: BT1.1 (V+), BT1.2 (V+), U13.3 (VBAT)
/SMC/~SMC_NMI: D14.1 (K), JP8.1 (A), U12.19 (PA1)
/SMC/~SMC_RESET: J21.5, R9.1, U12.10 (~RESET/PB7)
GND: BT1.3 (V-), C5.1, C16.2, C17.2, D4.1 (K), D5.1 (K), D18.1 (K), J7.1, J16.3 (GND), J16.5 (GND), J16.7 (GND), J16.15 (GND), J16.17 (GND), J16.18 (GND), J16.19 (GND), J16.24 (GND), J21.6, J26.3, J26.4, R34.1, RN5.6 (R3.2), RN5.8 (R4.2), U12.6 (GND), U12.16 (AGND), U13.4 (VSS); also elsewhere on the board
unnamed: D4.2 (A), R32.2
unnamed: D5.2 (A), JP3.2 (B)
unnamed: J6.1, R34.2, SW3.2
unnamed: JP3.1 (A), R33.2
unnamed: JP5.2 (B), R32.1
unnamed: JP6.2 (B), R31.1
unnamed: C16.1, U13.1 (X1), Y1.1
unnamed: C17.1, U13.2 (X2), Y1.2
PS2K_CLK: U12.18 (PA2); also elsewhere on the board
PS2K_DAT: U12.4 (PB3); also elsewhere on the board
PS2M_CLK: U12.9 (PB6); also elsewhere on the board
PS2M_DAT: U12.8 (XTAL2/PB5); also elsewhere on the board
PS2_PWR: J25.2; also elsewhere on the board
PWR_OK: J16.8 (PWR_OK), U12.17 (AREF/PA3)
SCL: Q2.1 (S); also elsewhere on the board
SDA: Q1.1 (S); also elsewhere on the board
~NMI: D14.2 (A); also elsewhere on the board
~PS_ON: J16.16 (PS_ON#), U12.13 (PA5)
~RES: U12.20 (PA0); also elsewhere on the board
~SMC_IRQ: J21.1, U12.2 (PB1); also elsewhere on the board

Notes on the sheet:
Real-Time Clock
Powering PS/2 from standby power allows for "waking" computer on a key stroke.
ATX Power
I2C Power Domain Isolation
ISP Header
