RetroRemake/OtterX/Sirius_DV1/OtterX.kicad_pcb

## KiCad design Sirius_DV1/OtterX.kicad_pcb (continued)

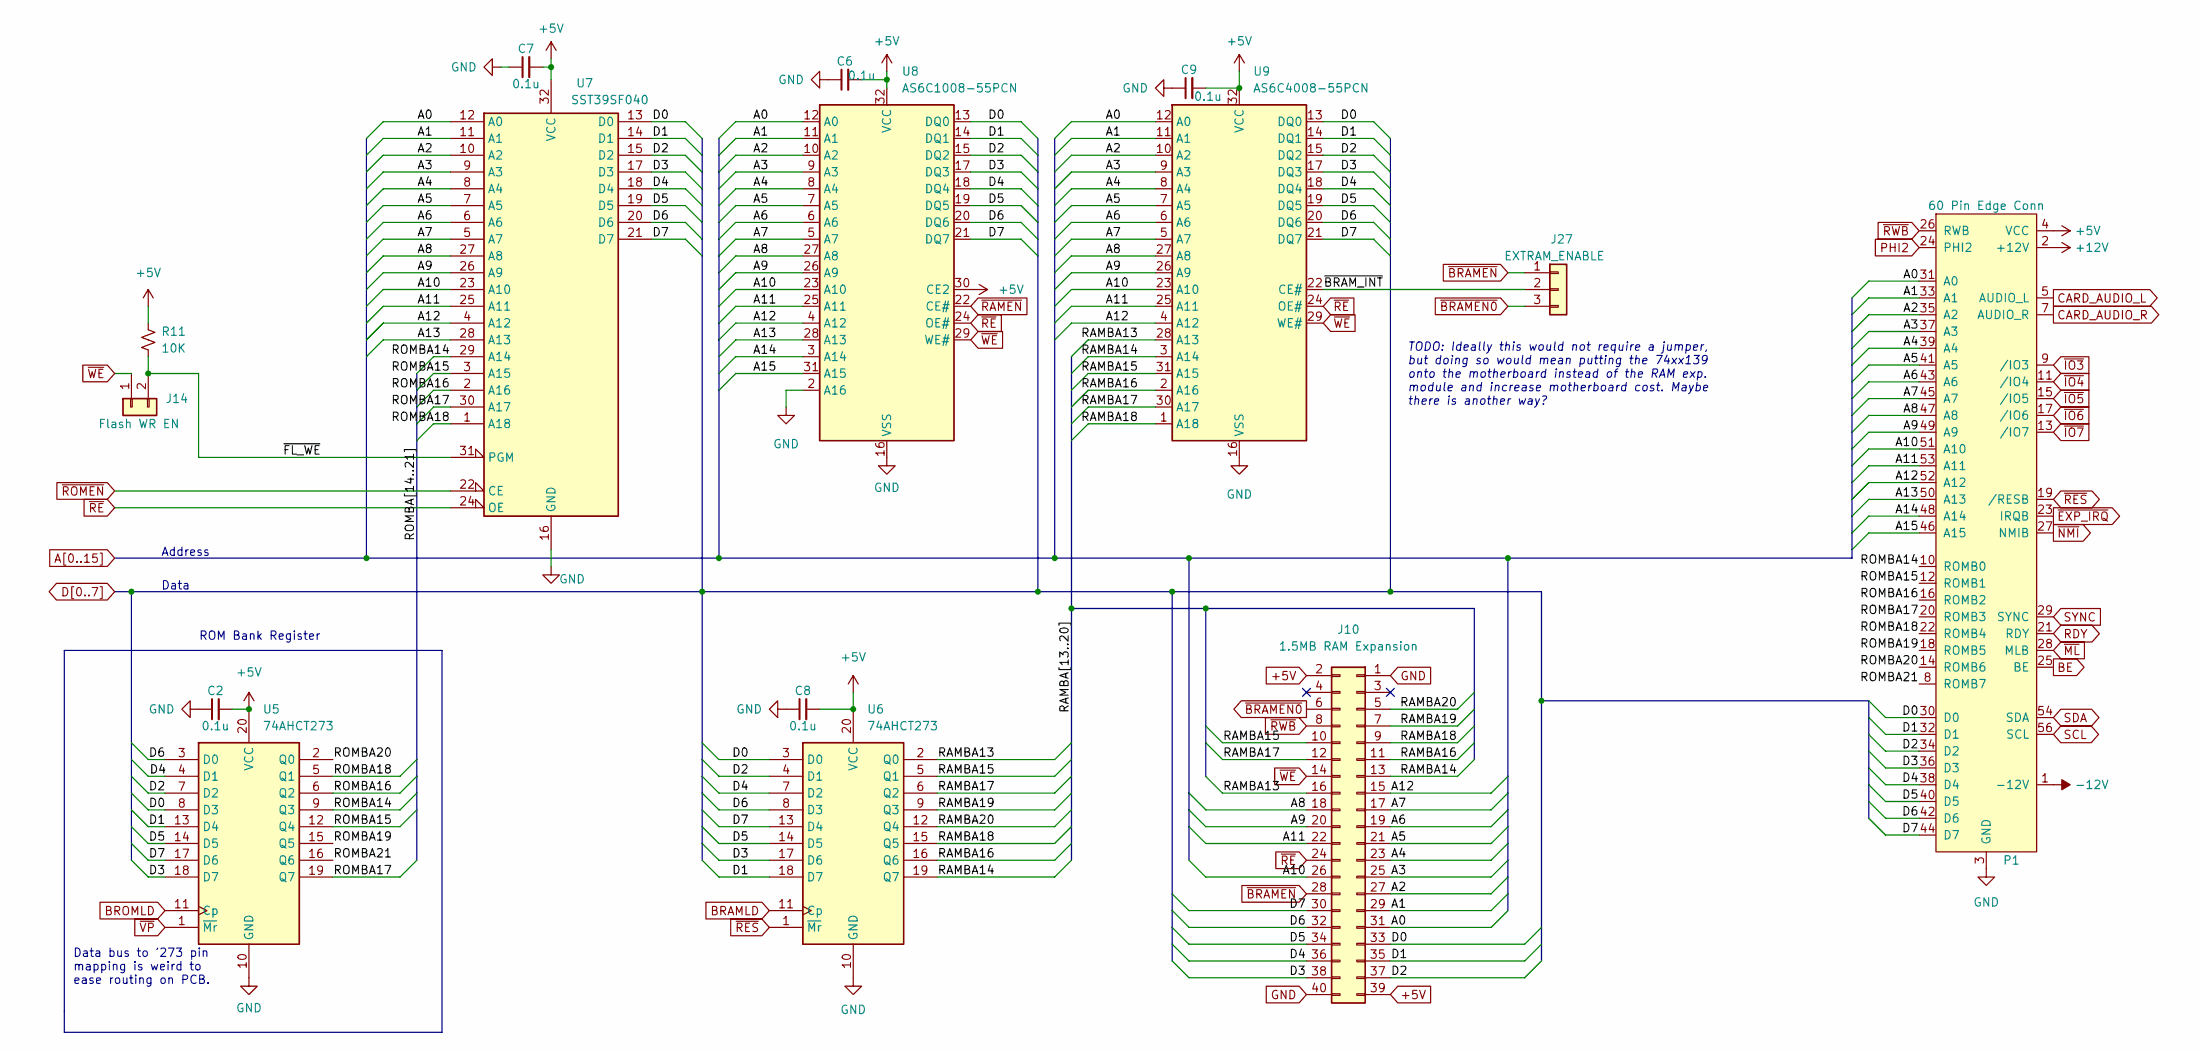
[picture p6: schematic memory.kicad_sch, OtterX]

Parts:
C2, C6, C7, C8, C9: 0.1u; C_Disc_D4.3mm_W1.9mm_P5.00mm
J10: 1.5MB RAM Expansion; PinSocket_2x20_P2.00mm_Vertical
J14: Flash WR EN; PinHeader_1x02_P2.54mm_Vertical
J27: EXTRAM_ENABLE; PinHeader_1x03_P2.00mm_Vertical
P1: 60 Pin Edge Conn; TE155308438
R11: 10K; R_Axial_DIN0207_L6.3mm_D2.5mm_P7.62mm_Horizontal
U5, U6: 74AHCT273; DIP-20_W7.62mm_ShortWidePads
U7: SST39SF040; DIP_Socket-32_W11.9_W12.7_W15.24_W17.78_W18.5_3M_232-1285-0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
U8: AS6C1008-55PCN; DIP-32_W15.24mm_ShortWidePads
U9: AS6C4008-55PCN; DIP-32_W15.24mm_ShortWidePads

Connections:
+5V: C2.2, C6.2, C7.2, C8.2, C9.2, J10.2, J10.39, P1.4 (VCC), P1.57 (VCC), R11.1, U5.20 (VCC), U6.20 (VCC), U7.32 (VCC), U8.30 (CE2), U8.32 (VCC), U9.32 (VCC); also elsewhere on the board
+12V: P1.2 (+12V), P1.59 (+12V); also elsewhere on the board
-12V: P1.1 (-12V), P1.60 (-12V); also elsewhere on the board
/Memory/RAMBA13: J10.16, U6.2 (Q0), U9.28 (A13)
/Memory/RAMBA14: J10.13, U6.19 (Q7), U9.3 (A14)
/Memory/RAMBA15: J10.10, U6.5 (Q1), U9.31 (A15)
/Memory/RAMBA16: J10.11, U6.16 (Q6), U9.2 (A16)
/Memory/RAMBA17: J10.12, U6.6 (Q2), U9.30 (A17)
/Memory/RAMBA18: J10.9, U6.15 (Q5), U9.1 (A18)
/Memory/RAMBA19: J10.7, U6.9 (Q3)
/Memory/RAMBA20: J10.5, U6.12 (Q4)
/Memory/ROMBA14: P1.10 (ROMB0), U5.9 (Q3), U7.29 (A14)
/Memory/ROMBA15: P1.12 (ROMB1), U5.12 (Q4), U7.3 (A15)
/Memory/ROMBA16: P1.16 (ROMB2), U5.6 (Q2), U7.2 (A16)
/Memory/ROMBA17: P1.20 (ROMB3), U5.19 (Q7), U7.30 (A17)
/Memory/ROMBA18: P1.22 (ROMB4), U5.5 (Q1), U7.1 (A18)
/Memory/ROMBA19: P1.18 (ROMB5), U5.15 (Q5)
/Memory/ROMBA20: P1.14 (ROMB6), U5.2 (Q0)
/Memory/ROMBA21: P1.8 (ROMB7), U5.16 (Q6)
/Memory/~BRAM_INT: J27.2, U9.22 (CE#)
/Memory/~FL_WE: J14.2, R11.2, U7.31 (PGM)
A0: J10.31, P1.31 (A0), U7.12 (A0), U8.12 (A0), U9.12 (A0); also elsewhere on the board
A1: J10.29, P1.33 (A1), U7.11 (A1), U8.11 (A1), U9.11 (A1); also elsewhere on the board
A2: J10.27, P1.35 (A2), U7.10 (A2), U8.10 (A2), U9.10 (A2); also elsewhere on the board
A3: J10.25, P1.37 (A3), U7.9 (A3), U8.9 (A3), U9.9 (A3); also elsewhere on the board
A4: J10.23, P1.39 (A4), U7.8 (A4), U8.8 (A4), U9.8 (A4); also elsewhere on the board
A5: J10.21, P1.41 (A5), U7.7 (A5), U8.7 (A5), U9.7 (A5); also elsewhere on the board
A6: J10.19, P1.43 (A6), U7.6 (A6), U8.6 (A6), U9.6 (A6); also elsewhere on the board
A7: J10.17, P1.45 (A7), U7.5 (A7), U8.5 (A7), U9.5 (A7); also elsewhere on the board
A8: J10.18, P1.47 (A8), U7.27 (A8), U8.27 (A8), U9.27 (A8); also elsewhere on the board
A9: J10.20, P1.49 (A9), U7.26 (A9), U8.26 (A9), U9.26 (A9); also elsewhere on the board
A10: J10.26, P1.51 (A10), U7.23 (A10), U8.23 (A10), U9.23 (A10); also elsewhere on the board
A11: J10.22, P1.53 (A11), U7.25 (A11), U8.25 (A11), U9.25 (A11); also elsewhere on the board
A12: J10.15, P1.52 (A12), U7.4 (A12), U8.4 (A12), U9.4 (A12); also elsewhere on the board
A13: P1.50 (A13), U7.28 (A13), U8.28 (A13); also elsewhere on the board
A14: P1.48 (A14), U8.3 (A14); also elsewhere on the board
A15: P1.46 (A15), U8.31 (A15); also elsewhere on the board
BE: P1.25 (BE); also elsewhere on the board
BRAMLD: U6.11 (Cp); also elsewhere on the board
BROMLD: U5.11 (Cp); also elsewhere on the board
CARD_AUDIO_L: P1.5 (AUDIO_L); also elsewhere on the board
CARD_AUDIO_R: P1.7 (AUDIO_R); also elsewhere on the board
D0: J10.33, P1.30 (D0), U5.8 (D3), U6.3 (D0), U7.13 (D0), U8.13 (DQ0), U9.13 (DQ0); also elsewhere on the board
D1: J10.35, P1.32 (D1), U5.13 (D4), U6.18 (D7), U7.14 (D1), U8.14 (DQ1), U9.14 (DQ1); also elsewhere on the board
D2: J10.37, P1.34 (D2), U5.7 (D2), U6.4 (D1), U7.15 (D2), U8.15 (DQ2), U9.15 (DQ2); also elsewhere on the board
D3: J10.38, P1.36 (D3), U5.18 (D7), U6.17 (D6), U7.17 (D3), U8.17 (DQ3), U9.17 (DQ3); also elsewhere on the board
D4: J10.36, P1.38 (D4), U5.4 (D1), U6.7 (D2), U7.18 (D4), U8.18 (DQ4), U9.18 (DQ4); also elsewhere on the board
D5: J10.34, P1.40 (D5), U5.14 (D5), U6.14 (D5), U7.19 (D5), U8.19 (DQ5), U9.19 (DQ5); also elsewhere on the board
D6: J10.32, P1.42 (D6), U5.3 (D0), U6.8 (D3), U7.20 (D6), U8.20 (DQ6), U9.20 (DQ6); also elsewhere on the board
D7: J10.30, P1.44 (D7), U5.17 (D6), U6.13 (D4), U7.21 (D7), U8.21 (DQ7), U9.21 (DQ7); also elsewhere on the board
GND: C2.1, C6.1, C7.1, C8.1, C9.1, J10.1, J10.40, P1.3 (GND), P1.6 (GND), P1.55 (GND), P1.58 (GND), U5.10 (GND), U6.10 (GND), U7.16 (GND), U8.2 (A16), U8.16 (VSS), U9.16 (VSS); also elsewhere on the board
PHI2: P1.24 (PHI2); also elsewhere on the board
RDY: P1.21 (RDY); also elsewhere on the board
SCL: P1.56 (SCL); also elsewhere on the board
SDA: P1.54 (SDA); also elsewhere on the board
SYNC: P1.29 (SYNC); also elsewhere on the board
~BRAMEN0: J10.6, J27.3
~BRAMEN: J10.28, J27.1; also elsewhere on the board
~EXP_IRQ: P1.23 (IRQB); also elsewhere on the board
~IO3: P1.9 (/IO3); also elsewhere on the board
~IO4: P1.11 (/IO4); also elsewhere on the board
~IO5: P1.15 (/IO5); also elsewhere on the board
~IO6: P1.17 (/IO6); also elsewhere on the board
~IO7: P1.13 (/IO7); also elsewhere on the board
~ML: P1.28 (MLB); also elsewhere on the board
~NMI: P1.27 (NMIB); also elsewhere on the board
~RAMEN: U8.22 (CE#); also elsewhere on the board
~RES: P1.19 (/RESB), U6.1 (~Mr); also elsewhere on the board
~RE: J10.24, U7.24 (OE), U8.24 (OE#), U9.24 (OE#); also elsewhere on the board
~ROMEN: U7.22 (CE); also elsewhere on the board
~RWB: J10.8, P1.26 (RWB); also elsewhere on the board
~VP: U5.1 (~Mr); also elsewhere on the board
~WE: J10.14, J14.1, U8.29 (WE#), U9.29 (WE#); also elsewhere on the board

Notes on the sheet:
Address
Data bus to '273 pin mapping is weird to ease routing on PCB.
TODO: Ideally this would not require a jumper, but doing so would mean putting the 74xx139 onto the motherboard instead of the RAM exp. module and increase motherboard cost. Maybe there is another way?
Data
ROM Bank Register

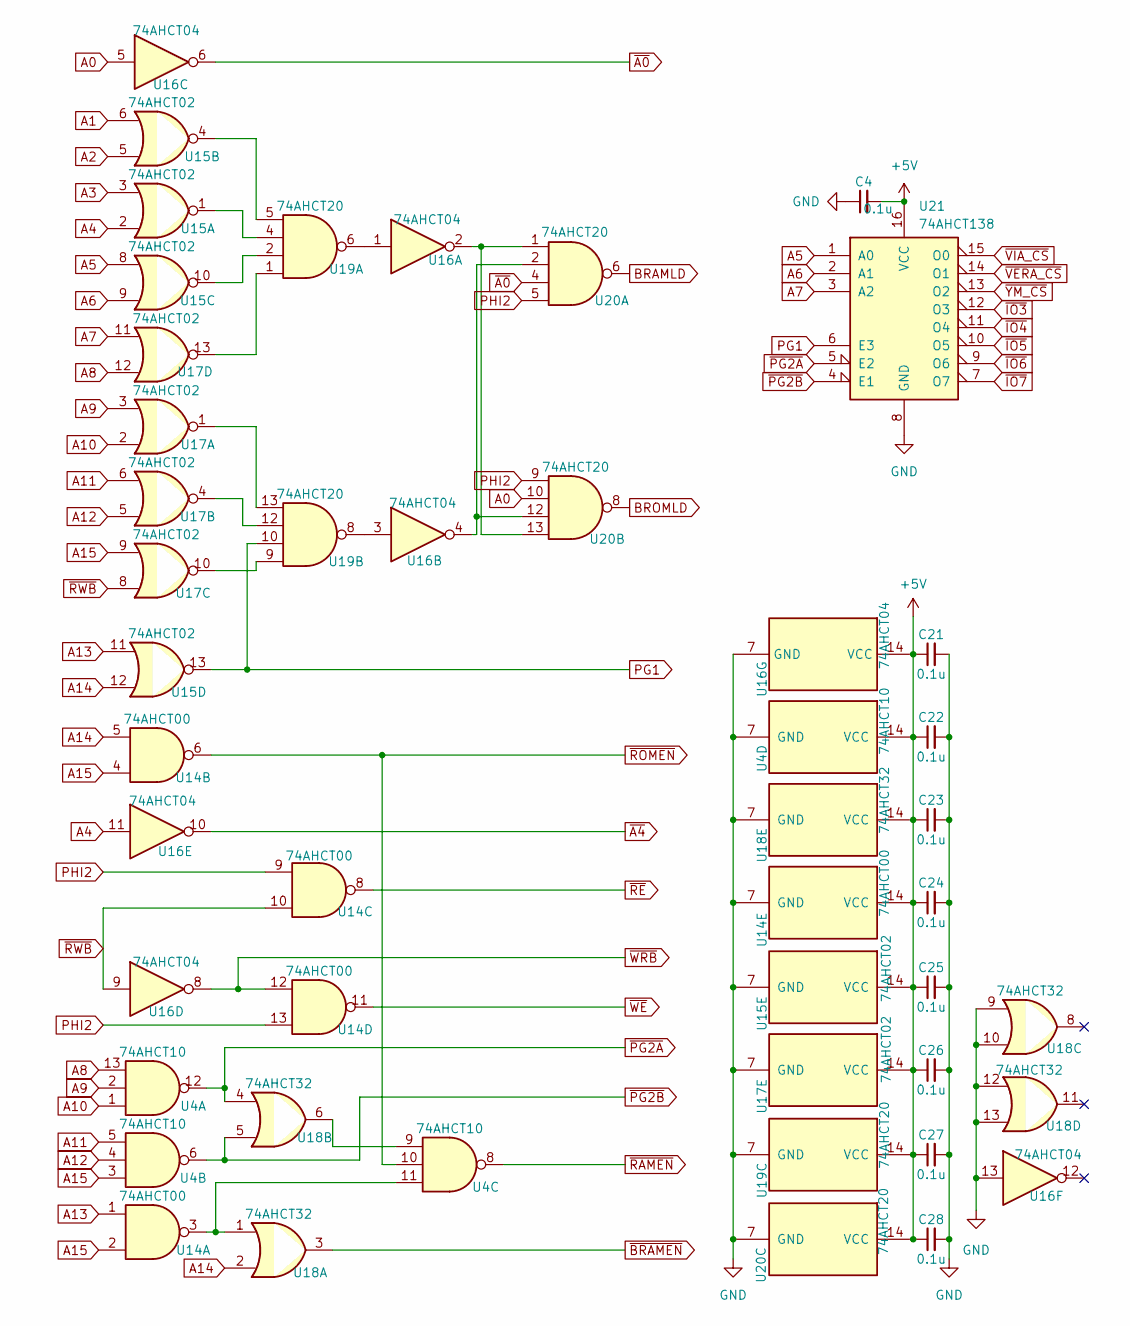
[picture p7: schematic bus_decoder.kicad_sch, OtterX]

Parts:
C4, C21, C22, C23, C24, C25, C26, C27, C28: 0.1u; C_Disc_D4.3mm_W1.9mm_P5.00mm
U4: 74AHCT10; DIP-14_W7.62mm_ShortWidePads
U14: 74AHCT00; DIP-14_W7.62mm_ShortWidePads
U15, U17: 74AHCT02; DIP-14_W7.62mm_ShortWidePads
U16: 74AHCT04; DIP-14_W7.62mm_ShortWidePads
U18: 74AHCT32; DIP-14_W7.62mm_ShortWidePads
U19, U20: 74AHCT20; DIP-14_W7.62mm_ShortWidePads
U21: 74AHCT138; DIP-16_W7.62mm_ShortWidePads

Connections:
+5V: C4.2, C21.1, C22.1, C23.1, C24.1, C25.1, C26.1, C27.1, C28.1, U4.14 (VCC), U14.14 (VCC), U15.14 (VCC), U16.14 (VCC), U17.14 (VCC), U18.14 (VCC), U19.14 (VCC), U20.14 (VCC), U21.16 (VCC); also elsewhere on the board
A0: U16.5, U20.10; also elsewhere on the board
A1: U15.6; also elsewhere on the board
A2: U15.5; also elsewhere on the board
A3: U15.3; also elsewhere on the board
A4: U15.2, U16.11; also elsewhere on the board
A5: U15.8, U21.1 (A0); also elsewhere on the board
A6: U15.9, U21.2 (A1); also elsewhere on the board
A7: U17.11, U21.3 (A2); also elsewhere on the board
A8: U4.13, U17.12; also elsewhere on the board
A9: U4.2, U17.3; also elsewhere on the board
A10: U4.1, U17.2; also elsewhere on the board
A11: U4.5, U17.6; also elsewhere on the board
A12: U4.4, U17.5; also elsewhere on the board
A13: U14.1, U15.11; also elsewhere on the board
A14: U14.5, U15.12, U18.2; also elsewhere on the board
A15: U4.3, U14.2, U14.4, U17.9; also elsewhere on the board
BRAMLD: U20.6; also elsewhere on the board
BROMLD: U20.8; also elsewhere on the board
GND: C4.1, C21.2, C22.2, C23.2, C24.2, C25.2, C26.2, C27.2, C28.2, U4.7 (GND), U14.7 (GND), U15.7 (GND), U16.7 (GND), U16.13, U17.7 (GND), U18.7 (GND), U18.9, U18.10, U18.12, U18.13, U19.7 (GND), U20.7 (GND), U21.8 (GND); also elsewhere on the board
unnamed: U4.11, U14.3, U18.1
unnamed: U15.1, U19.4
unnamed: U15.4, U19.5
unnamed: U15.10, U19.2
unnamed: U16.1, U19.6
unnamed: U16.2, U20.1, U20.13
unnamed: U16.3, U19.8
unnamed: U16.4, U20.2, U20.12
unnamed: U17.1, U19.13
unnamed: U17.4, U19.12
unnamed: U17.10, U19.9
unnamed: U17.13, U19.1
unnamed: U4.9, U18.6
PG1: U15.13, U19.10, U21.6 (E3)
PHI2: U14.9, U14.13, U20.5, U20.9; also elsewhere on the board
~A0: U16.6, U20.4
~A4: U16.10; also elsewhere on the board
~BRAMEN: U18.3; also elsewhere on the board
~IO3: U21.12 (O3); also elsewhere on the board
~IO4: U21.11 (O4); also elsewhere on the board
~IO5: U21.10 (O5); also elsewhere on the board
~IO6: U21.9 (O6); also elsewhere on the board
~IO7: U21.7 (O7); also elsewhere on the board
~PG2A: U4.12, U18.4, U21.5 (E2)
~PG2B: U4.6, U18.5, U21.4 (E1)
~RAMEN: U4.8; also elsewhere on the board
~RE: U14.8; also elsewhere on the board
~ROMEN: U4.10, U14.6; also elsewhere on the board
~RWB: U14.10, U16.9, U17.8; also elsewhere on the board
~VERA_CS: U21.14 (O1); also elsewhere on the board
~VIA_CS: U21.15 (O0); also elsewhere on the board
~WE: U14.11; also elsewhere on the board
~WRB: U14.12, U16.8
~YM_CS: U21.13 (O2); also elsewhere on the board

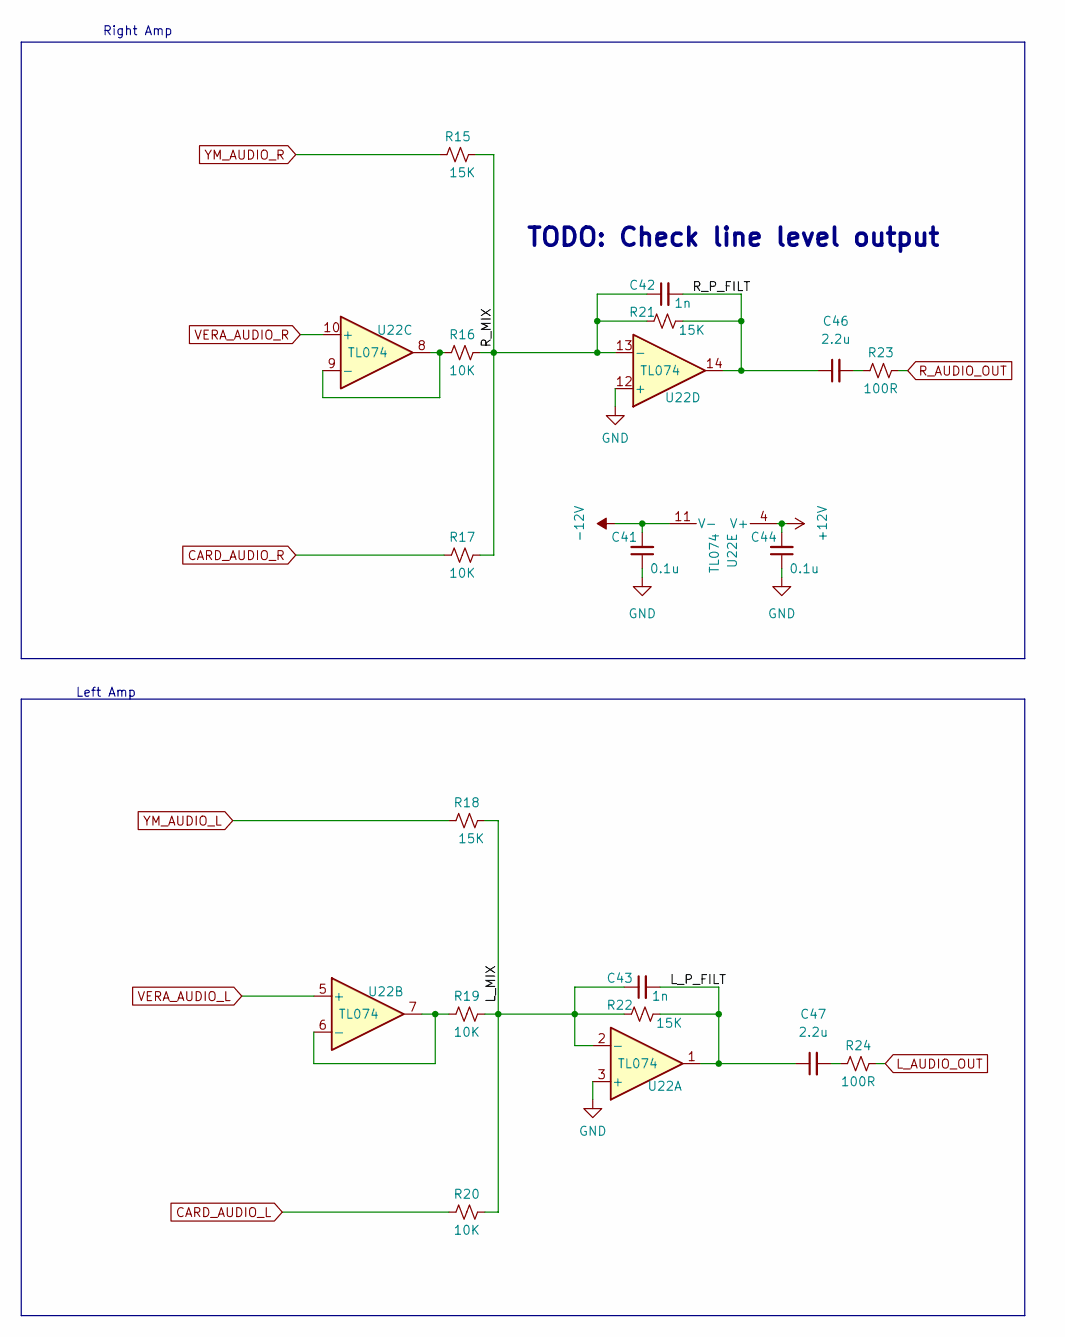
[picture p8: schematic Audio_Mixer.kicad_sch, OtterX]

Parts:
C41, C44: 0.1u; C_Disc_D4.3mm_W1.9mm_P5.00mm
C42, C43: 1n; C_Rect_L7.2mm_W2.5mm_P5.00mm_FKS2_FKP2_MKS2_MKP2
C46, C47: 2.2u; C_Rect_L10.3mm_W5.7mm_P7.50mm_MKS4
R15, R18, R21, R22: 15K; R_Axial_DIN0207_L6.3mm_D2.5mm_P7.62mm_Horizontal
R16, R17, R19, R20: 10K; R_Axial_DIN0207_L6.3mm_D2.5mm_P7.62mm_Horizontal
R23, R24: 100R; R_Axial_DIN0207_L6.3mm_D2.5mm_P7.62mm_Horizontal
U22: TL074; DIP-14_W7.62mm_ShortWidePads

Connections:
+12V: C44.2, U22.4 (V+); also elsewhere on the board
-12V: C41.2, U22.11 (V-); also elsewhere on the board
/Audio/Audio Mixer/L_MIX: C43.1, R18.2, R19.2, R20.2, R22.1, U22.2 (-)
/Audio/Audio Mixer/L_P_FILT: C43.2, C47.1, R22.2, U22.1
/Audio/Audio Mixer/R_MIX: C42.1, R15.2, R16.2, R17.2, R21.1, U22.13 (-)
/Audio/Audio Mixer/R_P_FILT: C42.2, C46.1, R21.2, U22.14
CARD_AUDIO_L: R20.1; also elsewhere on the board
CARD_AUDIO_R: R17.1; also elsewhere on the board
GND: C41.1, C44.1, U22.3 (+), U22.12 (+); also elsewhere on the board
L_AUDIO_OUT: R24.2; also elsewhere on the board
unnamed: C46.2, R23.1
unnamed: C47.2, R24.1
unnamed: R19.1, U22.6 (-), U22.7
unnamed: R16.1, U22.8, U22.9 (-)
R_AUDIO_OUT: R23.2; also elsewhere on the board
VERA_AUDIO_L: U22.5 (+); also elsewhere on the board
VERA_AUDIO_R: U22.10 (+); also elsewhere on the board
YM_AUDIO_L: R18.1; also elsewhere on the board
YM_AUDIO_R: R15.1; also elsewhere on the board

Notes on the sheet:
Right Amp
Left Amp
TODO: Check line level output

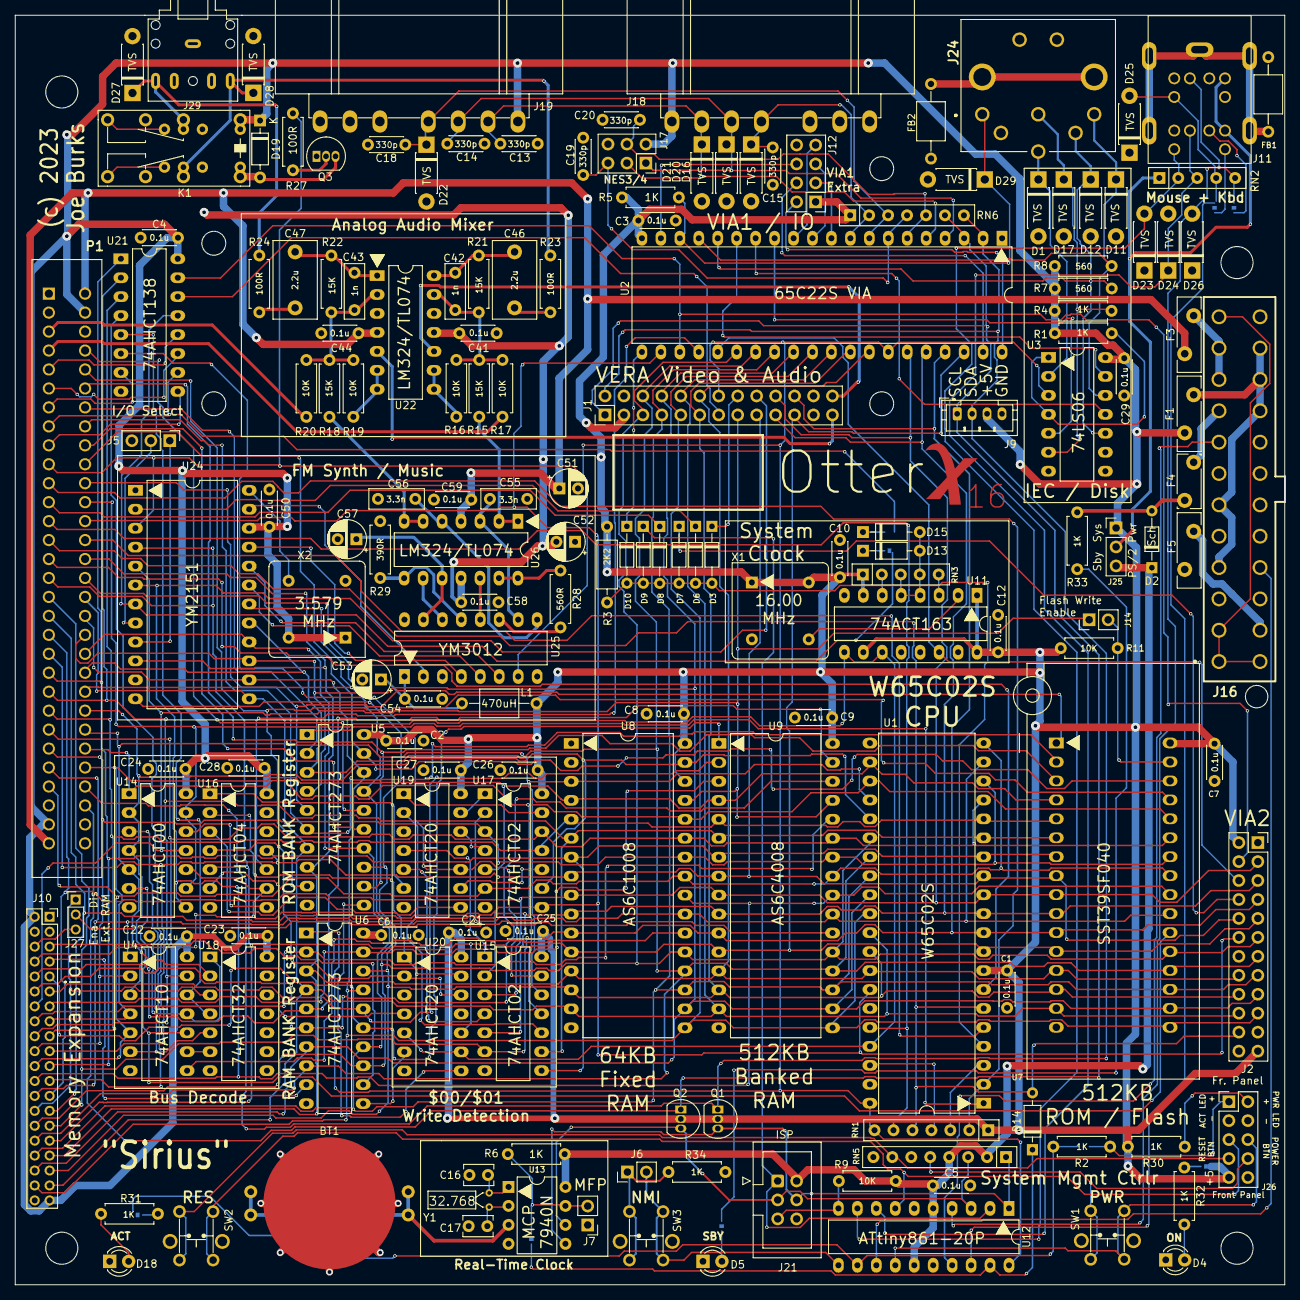
[picture p9: board OtterX.kicad_pcb from above]

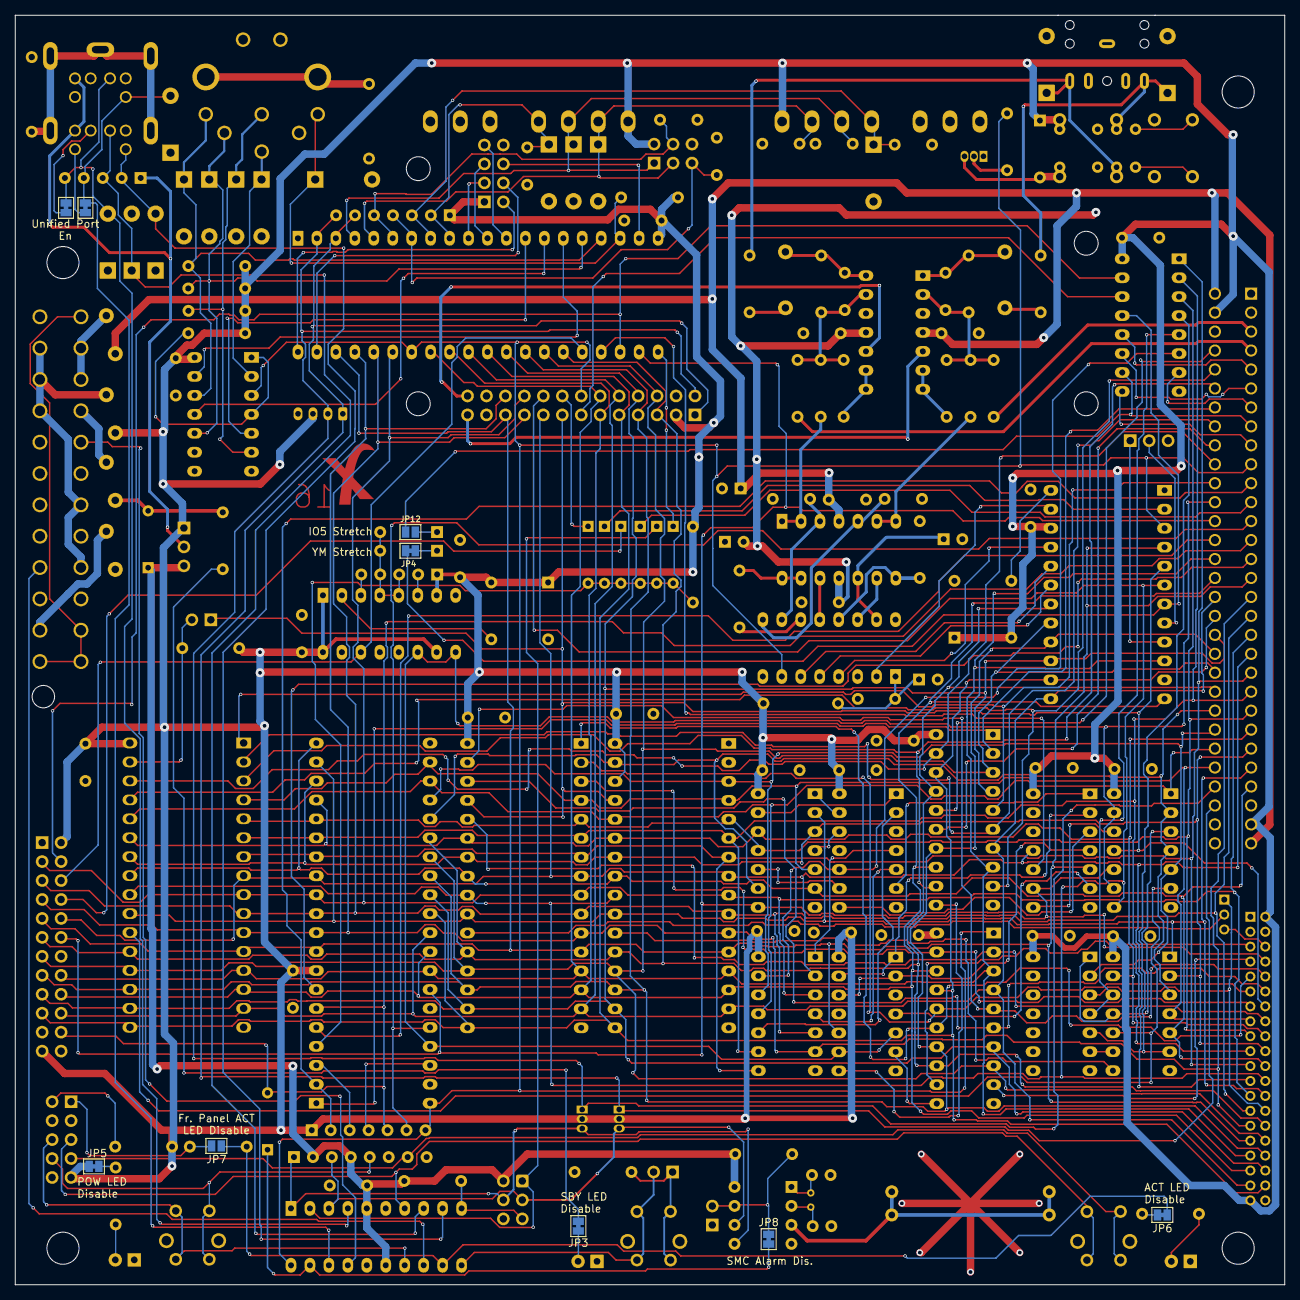
[picture p10: board OtterX.kicad_pcb from below]

Board: 4 copper layers, 170.1 x 170.1 mm, 186 parts (9 on the bottom side), 203 nets.
