RetroRemake/OtterX/MemoryExpansion/MemoryExpansion.kicad_pcb

## KiCad design MemoryExpansion/MemoryExpansion.kicad_pcb (2026-06-11)

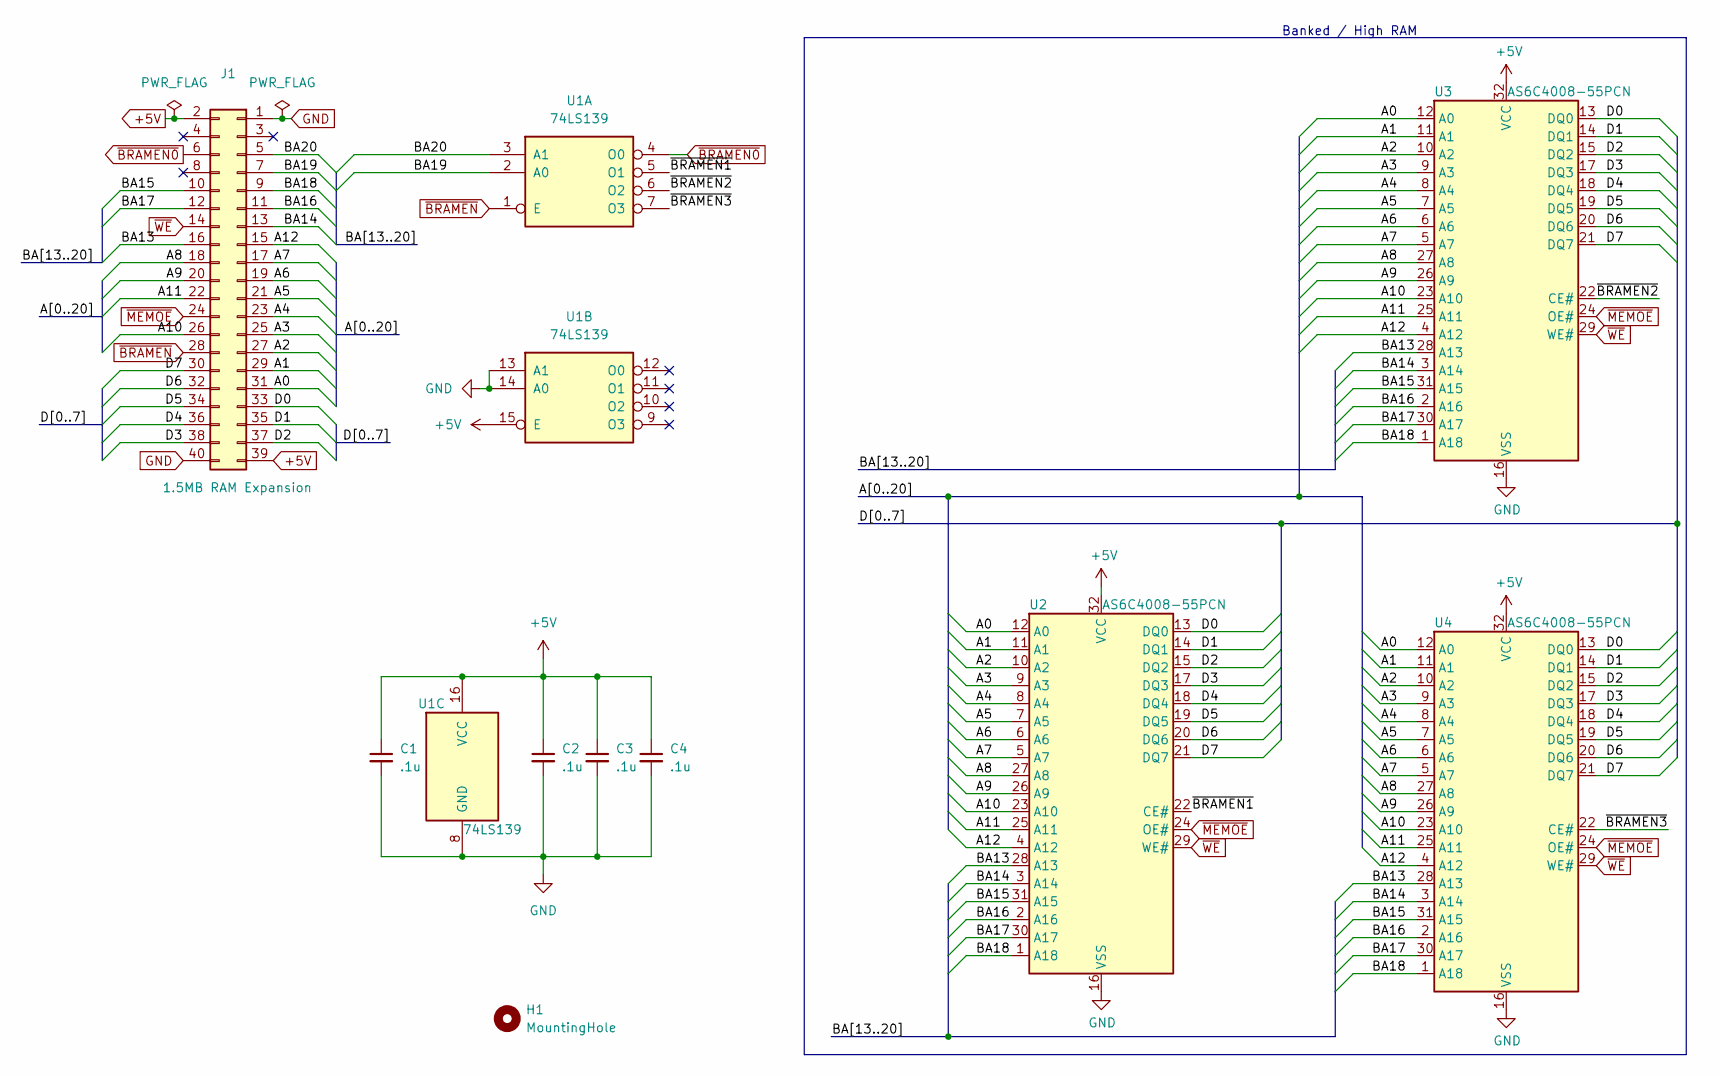
[picture p11: schematic MemoryExpansion.kicad_sch]

Parts:
C1, C2, C3, C4: .1u; C_Disc_D5.0mm_W2.5mm_P5.00mm
H1: MountingHole; MountingHole_2.2mm_M2
J1: 1.5MB RAM Expansion; PinHeader_2x20_P2.00mm_Vertical
U1: 74LS139; DIP-16_W7.62mm
U2, U3, U4: AS6C4008-55PCN; DIP-32_W15.24mm

Connections:
+5V: C1.1, C2.1, C3.1, C4.1, J1.2, J1.39, U1.15 (E), U1.16 (VCC), U2.32 (VCC), U3.32 (VCC), U4.32 (VCC)
/A0: J1.31, U2.12 (A0), U3.12 (A0), U4.12 (A0)
/A1: J1.29, U2.11 (A1), U3.11 (A1), U4.11 (A1)
/A2: J1.27, U2.10 (A2), U3.10 (A2), U4.10 (A2)
/A3: J1.25, U2.9 (A3), U3.9 (A3), U4.9 (A3)
/A4: J1.23, U2.8 (A4), U3.8 (A4), U4.8 (A4)
/A5: J1.21, U2.7 (A5), U3.7 (A5), U4.7 (A5)
/A6: J1.19, U2.6 (A6), U3.6 (A6), U4.6 (A6)
/A7: J1.17, U2.5 (A7), U3.5 (A7), U4.5 (A7)
/A8: J1.18, U2.27 (A8), U3.27 (A8), U4.27 (A8)
/A9: J1.20, U2.26 (A9), U3.26 (A9), U4.26 (A9)
/A10: J1.26, U2.23 (A10), U3.23 (A10), U4.23 (A10)
/A11: J1.22, U2.25 (A11), U3.25 (A11), U4.25 (A11)
/A12: J1.15, U2.4 (A12), U3.4 (A12), U4.4 (A12)
/BA13: J1.16, U2.28 (A13), U3.28 (A13), U4.28 (A13)
/BA14: J1.13, U2.3 (A14), U3.3 (A14), U4.3 (A14)
/BA15: J1.10, U2.31 (A15), U3.31 (A15), U4.31 (A15)
/BA16: J1.11, U2.2 (A16), U3.2 (A16), U4.2 (A16)
/BA17: J1.12, U2.30 (A17), U3.30 (A17), U4.30 (A17)
/BA18: J1.9, U2.1 (A18), U3.1 (A18), U4.1 (A18)
/BA19: J1.7, U1.2 (A0)
/BA20: J1.5, U1.3 (A1)
/D0: J1.33, U2.13 (DQ0), U3.13 (DQ0), U4.13 (DQ0)
/D1: J1.35, U2.14 (DQ1), U3.14 (DQ1), U4.14 (DQ1)
/D2: J1.37, U2.15 (DQ2), U3.15 (DQ2), U4.15 (DQ2)
/D3: J1.38, U2.17 (DQ3), U3.17 (DQ3), U4.17 (DQ3)
/D4: J1.36, U2.18 (DQ4), U3.18 (DQ4), U4.18 (DQ4)
/D5: J1.34, U2.19 (DQ5), U3.19 (DQ5), U4.19 (DQ5)
/D6: J1.32, U2.20 (DQ6), U3.20 (DQ6), U4.20 (DQ6)
/D7: J1.30, U2.21 (DQ7), U3.21 (DQ7), U4.21 (DQ7)
/~BRAMEN1: U1.5 (O1), U2.22 (CE#)
/~BRAMEN2: U1.6 (O2), U3.22 (CE#)
/~BRAMEN3: U1.7 (O3), U4.22 (CE#)
GND: C1.2, C2.2, C3.2, C4.2, J1.1, J1.40, U1.8 (GND), U1.13 (A1), U1.14 (A0), U2.16 (VSS), U3.16 (VSS), U4.16 (VSS)
~BRAMEN0: J1.6, U1.4 (O0)
~BRAMEN: J1.28, U1.1 (E)
~MEMOE: J1.24, U2.24 (OE#), U3.24 (OE#), U4.24 (OE#)
~WE: J1.14, U2.29 (WE#), U3.29 (WE#), U4.29 (WE#)

Notes on the sheet:
Banked / High RAM

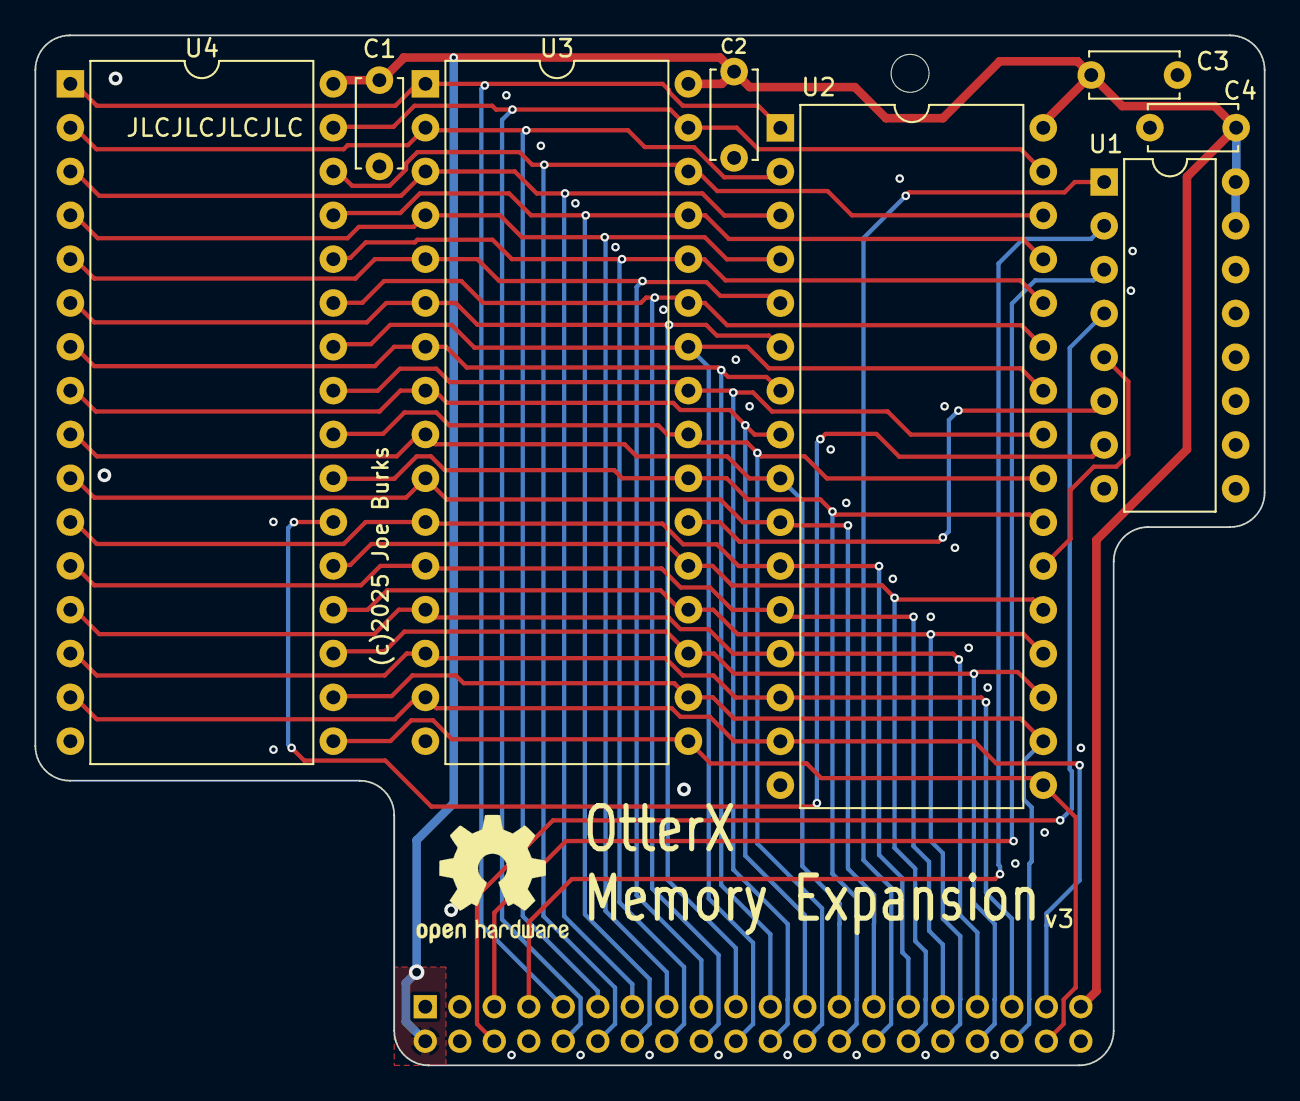
[picture p12: board MemoryExpansion.kicad_pcb from above]

Board: 4 copper layers, 71.3 x 59.7 mm, 10 parts (1 on the bottom side), 38 nets.
