RetroRemake/OtterX/DOtterBoards/IEC/IEC_Dongle.kicad_pcb

## KiCad design DOtterBoards/IEC/IEC_Dongle.kicad_pcb (2026-06-11)

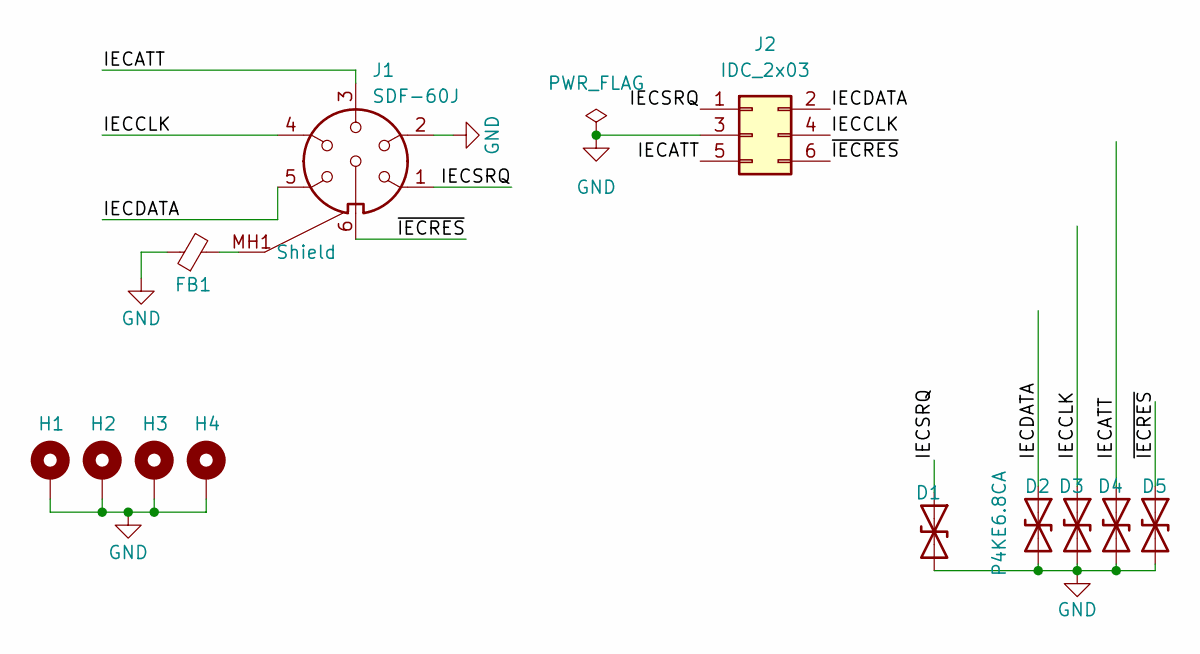
[picture p13: schematic IEC_Dongle.kicad_sch]

Parts:
D1, D2, D3, D4, D5: P4KE6.8CA; D_DO-41_SOD81_P7.62mm_Horizontal
FB1: FerriteBead_Small; L_Axial_L5.0mm_D3.6mm_P10.00mm_Horizontal_Murata_BL01RN1A2A2
H1, H2, H3, H4: MountingHole_Pad; MountingHole_2.7mm_M2.5_Pad_Via
J1: SDF-60J; SDF60J
J2: IDC_2x03; IDC-Header_2x03_P2.54mm_Vertical

Connections:
/IECATT: D4.1 (A1), J1.3, J2.5
/IECCLK: D3.1 (A1), J1.4, J2.4
/IECDATA: D2.1 (A1), J1.5, J2.2
/IECSRQ: D1.1 (A1), J1.1, J2.1
/~IECRES: D5.1 (A1), J1.6, J2.6
GND: D1.2 (A2), D2.2 (A2), D3.2 (A2), D4.2 (A2), D5.2 (A2), FB1.1, H1.1, H2.1, H3.1, H4.1, J1.2, J2.3
unnamed: FB1.2, J1.MH1 (Shield), J1.MH2

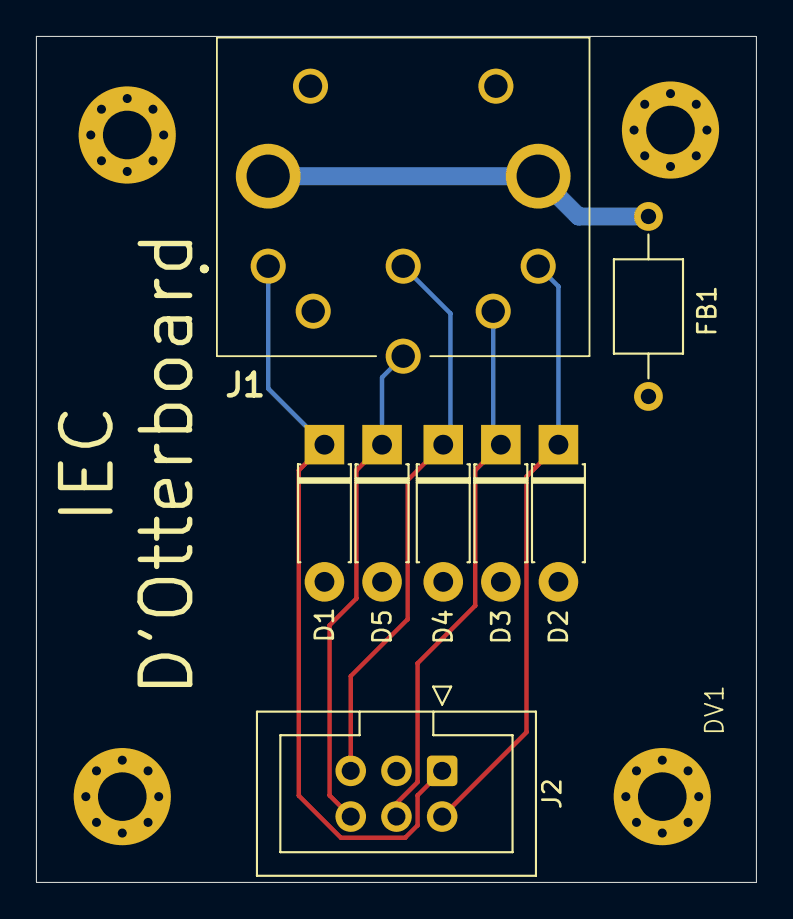
[picture p14: board IEC_Dongle.kicad_pcb from above]

Board: 2 copper layers, 40.0 x 47.0 mm, 12 parts (0 on the bottom side), 7 nets.
