RetroRemake/OtterX/DOtterBoards/SNES/SNES_Dongle.kicad_pcb

## KiCad design DOtterBoards/SNES/SNES_Dongle.kicad_pcb (2026-06-11)

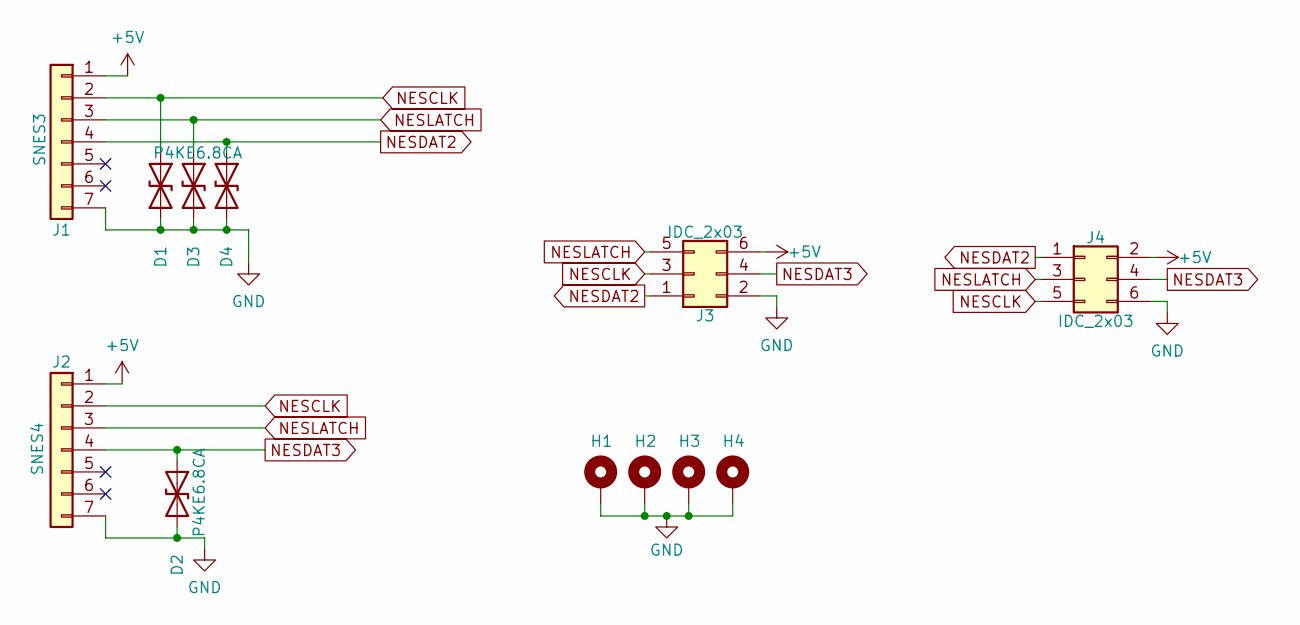
[picture p15: schematic SNES_Dongle.kicad_sch]

Parts:
D1, D2, D3, D4: P4KE6.8CA; D_DO-41_SOD81_P7.62mm_Horizontal
H1, H2, H3, H4: MountingHole_Pad; MountingHole_2.7mm_M2.5_Pad_Via
J1: SNES3; SNES_L
J2: SNES4; SNES_R
J3, J4: IDC_2x03; IDC-Header_2x03_P2.54mm_Vertical

Connections:
+5V: J1.1, J2.1, J3.6, J4.2
GND: D1.2 (A2), D2.2 (A2), D3.2 (A2), D4.2 (A2), H1.1, H2.1, H3.1, H4.1, J1.7, J2.7, J3.2, J4.6
NESCLK: D1.1 (A1), J1.2, J2.2, J3.3, J4.5
NESDAT2: D4.1 (A1), J1.4, J3.1, J4.1
NESDAT3: D2.1 (A1), J2.4, J3.4, J4.4
NESLATCH: D3.1 (A1), J1.3, J2.3, J3.5, J4.3
