RetroRemake/OtterX/DOtterBoards/SNES/SNES_Dongle.kicad_pcb

## KiCad design DOtterBoards/SNES/SNES_Dongle.kicad_pcb (continued)

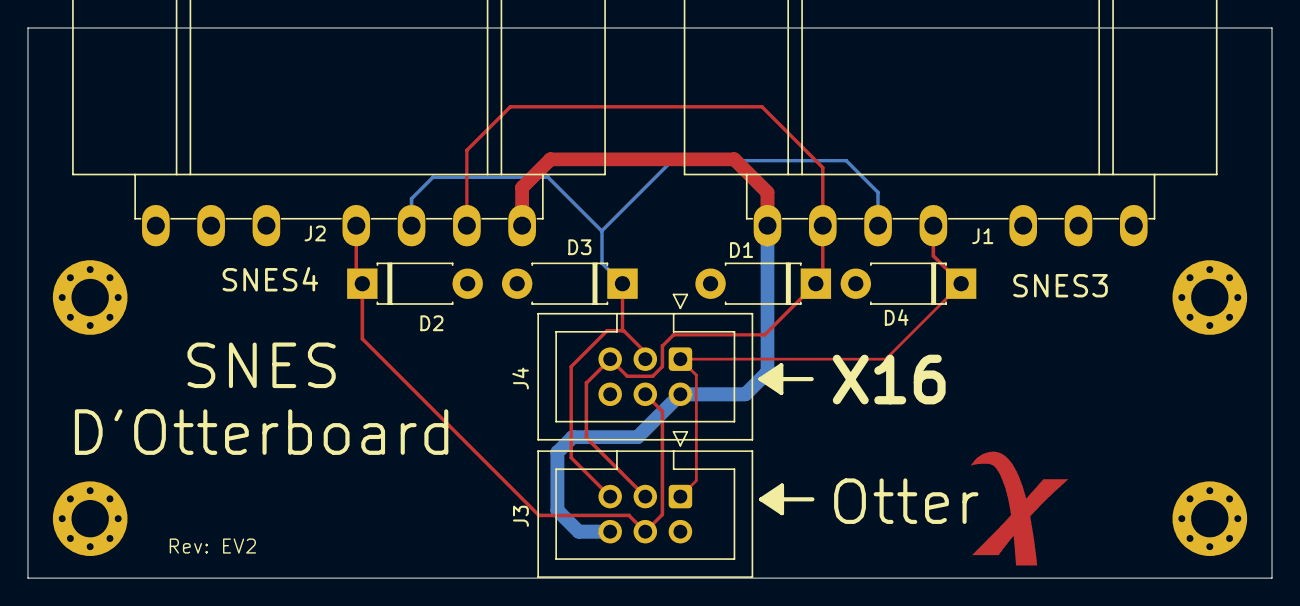
[picture p16: board SNES_Dongle.kicad_pcb from above]

Board: 2 copper layers, 90.0 x 39.8 mm, 12 parts (0 on the bottom side), 6 nets.
