RetroRemake/OtterX/BodgeBoard/BodgeBoard.kicad_pcb

## KiCad design BodgeBoard/BodgeBoard.kicad_pcb (2025-04-19)

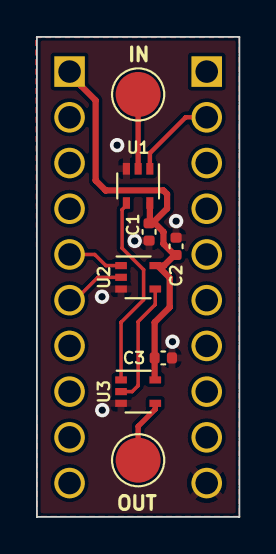
[picture p17: board BodgeBoard.kicad_pcb from above]

Board: 2 copper layers, 11.2 x 26.7 mm, 10 parts (0 on the bottom side), 9 nets.

Parts:
C1, C2, C3: C; C_0402_1005Metric
J1, J2: Conn_01x10_Pin; PinHeader_1x10_P2.54mm_Vertical
TP1: ~{ROMEN}; TestPoint_Pad_D2.5mm
TP2: ~{ROM0EN}; TestPoint_Pad_D2.5mm
U1, U2: SN74AHC1G02DCKR; SOT-353_SC-70-5
U3: SN74AHC1G00DCKR; SOT-353_SC-70-5

Connections:
+5V: C1.1, C2.1, C3.1, J1.1, U1.5 (VCC), U2.5 (VCC), U3.5 (VCC)
/ROMBA19: J1.6, U2.2
/ROMBA20: J2.2, U1.1
/ROMBA21: J1.5, U2.1
/~ROM0EN: TP2.1, U3.4
/~ROMEN: TP1.1, U1.2
GND: C1.2, C2.2, C3.2, J2.10, U1.3 (GND), U2.3 (GND), U3.3 (GND)
unnamed: U1.4, U3.1
unnamed: U2.4, U3.2
