RetroRemake/OtterX/(commit log)

2025-04-19 New open source repo
    [Audio_Mixer.kicad_sch, BodgeBoard.kicad_pcb, BodgeBoard.kicad_sch, Clock.kicad_sch, OtterX.kicad_sch, SMC.kicad_sch, audio.kicad_sch, bus_decoder.kicad_sch]
2025-04-20 Add memory expansion module
    [MemoryExpansion.kicad_pcb, MemoryExpansion.kicad_sch]
2025-05-18 Fixes for #1 #2 #3 #4 #5 #6 #7 #8 #10 #11 #14
    [Audio_Mixer.kicad_sch, Clock.kicad_sch, OtterX.kicad_sch, SMC.kicad_sch, audio.kicad_sch, bus_decoder.kicad_sch, memory.kicad_sch]
2025-06-14 Fix #16, widen transistor footprints
    [OtterX.kicad_pcb, SMC.kicad_sch, audio.kicad_sch]
2025-07-03 Misc layout fixes.
    [OtterX.kicad_pcb, OtterX.kicad_sch]
2025-07-12 Add IEC circuit back in, without the port.
    [Audio_Mixer.kicad_sch, OtterX.kicad_pcb, OtterX.kicad_sch, SMC.kicad_sch, audio.kicad_sch, bus_decoder.kicad_sch, memory.kicad_sch]
2025-07-15 More space between Edge and YM2151 Add IEC logic back in IDC headers for NES and IEC
    [Audio_Mixer.kicad_sch, OtterX.kicad_pcb, OtterX.kicad_sch, SMC.kicad_sch, audio.kicad_sch, bus_decoder.kicad_sch, memory.kicad_sch]
2025-07-16 Add dongle boards and new battery clip
    [IEC_Dongle.kicad_pcb, IEC_Dongle.kicad_sch, OtterX.kicad_pcb, OtterX.kicad_sch, SNES_Dongle.kicad_pcb, SNES_Dongle.kicad_sch]
2025-07-22 Change 2.2u cap footprint; update MemoryExpansion
    [Audio_Mixer.kicad_sch, MemoryExpansion.kicad_pcb, MemoryExpansion.kicad_sch, OtterX.kicad_pcb, OtterX.kicad_sch]
2025-07-23 Vega production Gerber Out
    [IEC_Dongle.kicad_pcb, OtterX.kicad_pcb, SNES_Dongle.kicad_pcb]
2025-07-23 Add IEC Dongle design
    [VIA2Expansion.kicad_pcb, VIA2Expansion.kicad_sch]
2025-11-05 Rename dongle boards to D'Otterboards
    [IEC_Dongle.kicad_pcb, IEC_Dongle.kicad_sch, SNES_Dongle.kicad_pcb, SNES_Dongle.kicad_sch]
2026-06-11 Add missing items
    [OtterX_Vega_Packing_List.xlsx]
