RetroRemake/OtterX/(notices)

Notices in the files:
Sirius_DV1/SMC.kicad_sch:
(C) 2023 Joe Burks
Vega_EV1/OtterX.kicad_pcb:
(c) 2025
MemoryExpansion/MemoryExpansion.kicad_pcb:
(c)2025 Joe Burks
Sirius_DV1/OtterX.kicad_pcb:
(c) 2023
